kauanSR-DEv/telemetria-esp32/docs/relatorio/README.md

# Relatório

[Abrir o relatório em PDF](<Relatorio_Telemetria_ESP32 OFICIAL.pdf>) · [Abrir em Word](<Relatorio_Telemetria_ESP32 OFICIAL.docx>).

O documento reúne a especificação, a montagem, os resultados das sete condições, as medidas de desempenho e o caso real de erro não detectado. Os [registros integrais](../../resultados/coletas/README.md) e as [tabelas](../../resultados/tabelas/README.md) permitem conferir os resultados.
