kauanSR-DEv/telemetria-esp32/resultados/README.md

# Resultados experimentais

As sete condições foram coletadas em 19/10/2026, com N = 1000 e semente 1. SUM cobre os modos 0 a 3; CRC-8 cobre os modos 1 a 3.

- [Tabelas consolidadas](tabelas/README.md): contagens, taxa e links para as rodadas.
- [Coletas completas](coletas/README.md): registros originais, CSVs e metadados.
- [Erro não detectado real](../docs/erro-nao-detectado.md): bytes e cálculo de SUM.

CRC-8 modo 1 é apresentado com ressalva de integridade documental, descrita no resumo da rodada. As demais seis condições passaram pela validação estrita. Os registros originais foram mantidos sem alteração.
