kauanSR-DEv/telemetria-esp32/resultados/tabelas/README.md

# Resultados consolidados

Somente rodadas válidas com 1000 classificações do RX. As ressalvas de registro, quando aceitas pela auditoria cruzada, são indicadas nos links. Se houver repetição, usa-se a pasta datada mais recente.

Taxa = ND / (CORROMPIDO + ND) × 100. NA: denominador zero.

## SUM

| Modo | OK | CORROMPIDO | PERDIDO | Não detectado | Taxa (%) |
|---|---:|---:|---:|---:|---:|
| 0 | 1000 | 0 | 0 | 0 | NA |
| 1 | 616 | 368 | 16 | 0 | 0 |
| 2 | 384 | 576 | 38 | 2 | 0.346021 |
| 3 | 174 | 740 | 86 | 0 | 0 |

- Modo 0: [resumo e logs](../coletas/20261019_174927_927081_SUM_M0_seed1/resumo.md) · semente 1
- Modo 1: [resumo e logs](../coletas/20261019_175048_578874_SUM_M1_seed1/resumo.md) · semente 1
- Modo 2: [resumo e logs](../coletas/20261019_175257_105181_SUM_M2_seed1/resumo.md) · semente 1
- Modo 3: [resumo e logs](../coletas/20261019_175441_404069_SUM_M3_seed1/resumo.md) · semente 1

## CRC8

| Modo | OK | CORROMPIDO | PERDIDO | Não detectado | Taxa (%) |
|---|---:|---:|---:|---:|---:|
| 1 | 621 | 363 | 16 | 0 | 0 |
| 2 | 399 | 563 | 38 | 0 | 0 |
| 3 | 167 | 747 | 86 | 0 | 0 |

- Modo 1: [resumo e logs](../coletas/20261019_180738_095814_CRC8_M1_seed1/resumo.md) · semente 1 · **com ressalvas de registro**
- Modo 2: [resumo e logs](../coletas/20261019_181355_979307_CRC8_M2_seed1/resumo.md) · semente 1
- Modo 3: [resumo e logs](../coletas/20261019_181546_219907_CRC8_M3_seed1/resumo.md) · semente 1
