kauanSR-DEv/telemetria-esp32/resultados/coletas/20261019_174927_927081_SUM_M0_seed1/resumo.md

# SUM · modo 0

Coleta: **VÁLIDA** · N = 1000 · semente = 1

| Modo | OK | CORROMPIDO | PERDIDO | Não detectado | Taxa (%) |
|---|---:|---:|---:|---:|---:|
| 0 | 1000 | 0 | 0 | 0 | NA |

A tabela descreve as decisões realmente registradas pelo RX. Apenas coletas válidas, inclusive com ressalvas explícitas, e com 1000 classificações entram nas tabelas finais.

| Medida | Média | Mínimo | Máximo | Amostras |
|---|---:|---:|---:|---:|
| calculo_tx_us | 1.001 | 1 | 2 | 1000 |
| verificacao_rx_us | 3.492 | 3 | 4 | 1000 |
| intervalo_tx_us | 50999.998999 | 50999 | 51000 | 999 |
| intervalo_rx_us | 51001.011011 | 50996 | 51957 | 999 |
| recuperacao_rx_ms | NA | NA | NA | 0 |

Overhead: 6 bytes por quadro, excluindo referência e bits de início/parada.
NA indica ausência de amostra ou denominador zero; não significa zero medido.

## Evidências

[TXT original do TX](tx.txt) · [TXT original do RX](rx.txt) · [TXT original do NOISE](noise.txt)

[Erros não detectados desta coleta](evidencias_nd.csv)
