kauanSR-DEv/telemetria-esp32/resultados/tabelas/CRC8.csv

Modo | OK | CORROMPIDO | PERDIDO | Não detectado | Taxa de não detecção (%)
1 | 621 | 363 | 16 | 0 | 0
2 | 399 | 563 | 38 | 0 | 0
3 | 167 | 747 | 86 | 0 | 0
