kauanSR-DEv/telemetria-esp32/resultados/coletas/20261019_174927_927081_SUM_M0_seed1/comandos.csv

horario_computador | placa | comando
2026-10-19T17:49:31.029342-04:00 | TX | STATUS
2026-10-19T17:49:31.029722-04:00 | TX | HELP
2026-10-19T17:49:31.080947-04:00 | RX | STATUS
2026-10-19T17:49:31.081238-04:00 | RX | HELP
2026-10-19T17:49:31.132462-04:00 | NOISE | STATUS
2026-10-19T17:49:31.132758-04:00 | NOISE | HELP
2026-10-19T17:49:31.163753-04:00 | TX | SUM
2026-10-19T17:49:31.194179-04:00 | RX | SUM
2026-10-19T17:49:31.224697-04:00 | NOISE | MODE 0
2026-10-19T17:49:31.255328-04:00 | NOISE | SEED 1
2026-10-19T17:49:31.286337-04:00 | RX | START 1000
2026-10-19T17:49:31.337244-04:00 | NOISE | START 1000
2026-10-19T17:49:31.398397-04:00 | TX | START 1000
2026-10-19T17:50:22.467437-04:00 | RX | END
2026-10-19T17:50:22.467819-04:00 | NOISE | END
