kauanSR-DEv/telemetria-esp32/resultados/coletas/20261019_174927_927081_SUM_M0_seed1/noise.csv

tipo | sessao | modo | indice | seq_original | t_sof_us | posicoes_byte_bit | alvos_hex | original_hex | receptor_hex | alvos_n | mudancas_n | xor_hex | eventos_planejados_ticks | atraso_max_ticks | eventos_aplicados_ticks | debug_original_hex | debug_receptor_hex | falhas_mask | qualidade
QUADRO | 3 | 0 | 0 | 0 | 3157584260 | NA | 0000000000000000 | A55A0200005E2977 | A55A0200005E2977 | 0 | 0 | 0000000000000000 | NA | 0 | NA | D3910000025E29 | D3910000025E29 | 0 | VALIDO
QUADRO | 3 | 0 | 1 | 1 | 3157635259 | NA | 0000000000000000 | A55A0200010DB937 | A55A0200010DB937 | 0 | 0 | 0000000000000000 | NA | 0 | NA | D3910001020DB9 | D3910001020DB9 | 0 | VALIDO
QUADRO | 3 | 0 | 2 | 2 | 3157686259 | NA | 0000000000000000 | A55A020002F55BAC | A55A020002F55BAC | 0 | 0 | 0000000000000000 | NA | 0 | NA | D391000202F55B | D391000202F55B | 0 | VALIDO
QUADRO | 3 | 0 | 3 | 3 | 3157737259 | NA | 0000000000000000 | A55A020003968FD6 | A55A020003968FD6 | 0 | 0 | 0000000000000000 | NA | 0 | NA | D391000302968F | D391000302968F | 0 | VALIDO
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
