kauanSR-DEv/telemetria-esp32/resultados/coletas/20261019_174927_927081_SUM_M0_seed1/rx.csv

sessao | tecnica | seq_original | seq_recebida | id_rx | t_sof_us | intervalo_us | residuo | decisao | payload_recebido | payload_referencia | payload_confere | verificacao_us | recuperacao_ms | classe | motivo | evento_seq
3 | SUM | 0 | 0 | 1 | 3015958233 | NA | 00 | ACEITO | 5E29 | 5E29 | SIM | 4 | NA | OK | NENHUM | ORDEM
3 | SUM | 1 | 1 | 2 | 3016009242 | 51009 | 00 | ACEITO | 0DB9 | 0DB9 | SIM | 4 | NA | OK | NENHUM | ORDEM
3 | SUM | 2 | 2 | 3 | 3016060241 | 50999 | 00 | ACEITO | F55B | F55B | SIM | 4 | NA | OK | NENHUM | ORDEM
3 | SUM | 3 | 3 | 4 | 3016111242 | 51001 | 00 | ACEITO | 968F | 968F | SIM | 4 | NA | OK | NENHUM | ORDEM
3 | SUM | 4 | 4 | 5 | 3016162241 | 50999 | 00 | ACEITO | A5F3 | A5F3 | SIM | 4 | NA | OK | NENHUM | ORDEM
3 | SUM | 5 | 5 | 6 | 3016213243 | 51002 | 00 | ACEITO | 1EAC | 1EAC | SIM | 4 | NA | OK | NENHUM | ORDEM
3 | SUM | 6 | 6 | 7 | 3016264242 | 50999 | 00 | ACEITO | 41AA | 41AA | SIM | 4 | NA | OK | NENHUM | ORDEM
3 | SUM | 7 | 7 | 8 | 3016315243 | 51001 | 00 | ACEITO | 59E0 | 59E0 | SIM | 4 | NA | OK | NENHUM | ORDEM
3 | SUM | 8 | 8 | 9 | 3016366242 | 50999 | 00 | ACEITO | E071 | E071 | SIM | 4 | NA | OK | NENHUM | ORDEM
3 | SUM | 9 | 9 | 10 | 3016417243 | 51001 | 00 | ACEITO | D691 | D691 | SIM | 4 | NA | OK | NENHUM | ORDEM
3 | SUM | 10 | 10 | 11 | 3016468242 | 50999 | 00 | ACEITO | 0154 | 0154 | SIM | 4 | NA | OK | NENHUM | ORDEM
3 | SUM | 11 | 11 | 12 | 3016519243 | 51001 | 00 | ACEITO | 05DA | 05DA | SIM | 4 | NA | OK | NENHUM | ORDEM
3 | SUM | 12 | 12 | 13 | 3016570242 | 50999 | 00 | ACEITO | 49A3 | 49A3 | SIM | 4 | NA | OK | NENHUM | ORDEM
3 | SUM | 13 | 13 | 14 | 3016621243 | 51001 | 00 | ACEITO | AEA4 | AEA4 | SIM | 4 | NA | OK | NENHUM | ORDEM
3 | SUM | 14 | 14 | 15 | 3016672242 | 50999 | 00 | ACEITO | B36F | B36F | SIM | 4 | NA | OK | NENHUM | ORDEM
3 | SUM | 15 | 15 | 16 | 3016723243 | 51001 | 00 | ACEITO | 53DB | 53DB | SIM | 4 | NA | OK | NENHUM | ORDEM
3 | SUM | 16 | 16 | 17 | 3016774242 | 50999 | 00 | ACEITO | E1AF | E1AF | SIM | 4 | NA | OK | NENHUM | ORDEM
3 | SUM | 17 | 17 | 18 | 3016825243 | 51001 | 00 | ACEITO | 8E6F | 8E6F | SIM | 4 | NA | OK | NENHUM | ORDEM
3 | SUM | 18 | 18 | 19 | 3016876243 | 51000 | 00 | ACEITO | 67A5 | 67A5 | SIM | 4 | NA | OK | NENHUM | ORDEM
3 | SUM | 19 | 19 | 20 | 3016927244 | 51001 | 00 | ACEITO | 58C7 | 58C7 | SIM | 4 | NA | OK | NENHUM | ORDEM
3 | SUM | 20 | 20 | 21 | 3016978243 | 50999 | 00 | ACEITO | 27D3 | 27D3 | SIM | 4 | NA | OK | NENHUM | ORDEM
3 | SUM | 21 | 21 | 22 | 3017029244 | 51001 | 00 | ACEITO | 7564 | 7564 | SIM | 4 | NA | OK | NENHUM | ORDEM
3 | SUM | 22 | 22 | 23 | 3017080243 | 50999 | 00 | ACEITO | 6061 | 6061 | SIM | 4 | NA | OK | NENHUM | ORDEM
3 | SUM | 23 | 23 | 24 | 3017131244 | 51001 | 00 | ACEITO | 2A09 | 2A09 | SIM | 4 | NA | OK | NENHUM | ORDEM
3 | SUM | 24 | 24 | 25 | 3017182243 | 50999 | 00 | ACEITO | 4244 | 4244 | SIM | 4 | NA | OK | NENHUM | ORDEM
3 | SUM | 25 | 25 | 26 | 3017233244 | 51001 | 00 | ACEITO | 47DA | 47DA | SIM | 4 | NA | OK | NENHUM | ORDEM
3 | SUM | 26 | 26 | 27 | 3017284243 | 50999 | 00 | ACEITO | EFB5 | EFB5 | SIM | 4 | NA | OK | NENHUM | ORDEM
3 | SUM | 27 | 27 | 28 | 3017335244 | 51001 | 00 | ACEITO | 8D2C | 8D2C | SIM | 4 | NA | OK | NENHUM | ORDEM
3 | SUM | 28 | 28 | 29 | 3017386243 | 50999 | 00 | ACEITO | E92C | E92C | SIM | 4 | NA | OK | NENHUM | ORDEM
3 | SUM | 29 | 29 | 30 | 3017437244 | 51001 | 00 | ACEITO | 92AA | 92AA | SIM | 4 | NA | OK | NENHUM | ORDEM
3 | SUM | 30 | 30 | 31 | 3017488243 | 50999 | 00 | ACEITO | CD3E | CD3E | SIM | 4 | NA | OK | NENHUM | ORDEM
3 | SUM | 31 | 31 | 32 | 3017539245 | 51002 | 00 | ACEITO | 6066 | 6066 | SIM | 4 | NA | OK | NENHUM | ORDEM
3 | SUM | 32 | 32 | 33 | 3017590244 | 50999 | 00 | ACEITO | CA1C | CA1C | SIM | 4 | NA | OK | NENHUM | ORDEM
3 | SUM | 33 | 33 | 34 | 3017641245 | 51001 | 00 | ACEITO | EACD | EACD | SIM | 4 | NA | OK | NENHUM | ORDEM
3 | SUM | 34 | 34 | 35 | 3017692244 | 50999 | 00 | ACEITO | 3F28 | 3F28 | SIM | 4 | NA | OK | NENHUM | ORDEM
3 | SUM | 35 | 35 | 36 | 3017743245 | 51001 | 00 | ACEITO | BAEC | BAEC | SIM | 4 | NA | OK | NENHUM | ORDEM
3 | SUM | 36 | 36 | 37 | 3017794244 | 50999 | 00 | ACEITO | 0FF3 | 0FF3 | SIM | 4 | NA | OK | NENHUM | ORDEM
3 | SUM | 37 | 37 | 38 | 3017845245 | 51001 | 00 | ACEITO | 774E | 774E | SIM | 4 | NA | OK | NENHUM | ORDEM
3 | SUM | 38 | 38 | 39 | 3017896244 | 50999 | 00 | ACEITO | 446B | 446B | SIM | 4 | NA | OK | NENHUM | ORDEM
3 | SUM | 39 | 39 | 40 | 3017947245 | 51001 | 00 | ACEITO | 8DC5 | 8DC5 | SIM | 4 | NA | OK | NENHUM | ORDEM
3 | SUM | 40 | 40 | 41 | 3017998244 | 50999 | 00 | ACEITO | C9DC | C9DC | SIM | 4 | NA | OK | NENHUM | ORDEM
3 | SUM | 41 | 41 | 42 | 3018049245 | 51001 | 00 | ACEITO | 5E83 | 5E83 | SIM | 4 | NA | OK | NENHUM | ORDEM
3 | SUM | 42 | 42 | 43 | 3018100244 | 50999 | 00 | ACEITO | E650 | E650 | SIM | 4 | NA | OK | NENHUM | ORDEM
3 | SUM | 43 | 43 | 44 | 3018151245 | 51001 | 00 | ACEITO | 18CB | 18CB | SIM | 4 | NA | OK | NENHUM | ORDEM
3 | SUM | 44 | 44 | 45 | 3018202243 | 50998 | 00 | ACEITO | 26D8 | 26D8 | SIM | 3 | NA | OK | NENHUM | ORDEM
3 | SUM | 45 | 45 | 46 | 3018253244 | 51001 | 00 | ACEITO | 40A3 | 40A3 | SIM | 4 | NA | OK | NENHUM | ORDEM
3 | SUM | 46 | 46 | 47 | 3018304243 | 50999 | 00 | ACEITO | 0040 | 0040 | SIM | 3 | NA | OK | NENHUM | ORDEM
3 | SUM | 47 | 47 | 48 | 3018355244 | 51001 | 00 | ACEITO | 9189 | 9189 | SIM | 4 | NA | OK | NENHUM | ORDEM
3 | SUM | 48 | 48 | 49 | 3018406243 | 50999 | 00 | ACEITO | 7CF8 | 7CF8 | SIM | 3 | NA | OK | NENHUM | ORDEM
3 | SUM | 49 | 49 | 50 | 3018457244 | 51001 | 00 | ACEITO | 58BB | 58BB | SIM | 4 | NA | OK | NENHUM | ORDEM
3 | SUM | 50 | 50 | 51 | 3018508243 | 50999 | 00 | ACEITO | 83E3 | 83E3 | SIM | 3 | NA | OK | NENHUM | ORDEM
3 | SUM | 51 | 51 | 52 | 3018559244 | 51001 | 00 | ACEITO | 5B1B | 5B1B | SIM | 4 | NA | OK | NENHUM | ORDEM
3 | SUM | 52 | 52 | 53 | 3018610243 | 50999 | 00 | ACEITO | F6B7 | F6B7 | SIM | 3 | NA | OK | NENHUM | ORDEM
3 | SUM | 53 | 53 | 54 | 3018661244 | 51001 | 00 | ACEITO | 38C8 | 38C8 | SIM | 4 | NA | OK | NENHUM | ORDEM
3 | SUM | 54 | 54 | 55 | 3018712243 | 50999 | 00 | ACEITO | 7597 | 7597 | SIM | 3 | NA | OK | NENHUM | ORDEM
3 | SUM | 55 | 55 | 56 | 3018763244 | 51001 | 00 | ACEITO | 0E86 | 0E86 | SIM | 4 | NA | OK | NENHUM | ORDEM
3 | SUM | 56 | 56 | 57 | 3018814243 | 50999 | 00 | ACEITO | 6A7A | 6A7A | SIM | 3 | NA | OK | NENHUM | ORDEM
3 | SUM | 57 | 57 | 58 | 3018865245 | 51002 | 00 | ACEITO | C42D | C42D | SIM | 4 | NA | OK | NENHUM | ORDEM
3 | SUM | 58 | 58 | 59 | 3018916244 | 50999 | 00 | ACEITO | E763 | E763 | SIM | 3 | NA | OK | NENHUM | ORDEM
3 | SUM | 59 | 59 | 60 | 3018967245 | 51001 | 00 | ACEITO | 5B8B | 5B8B | SIM | 4 | NA | OK | NENHUM | ORDEM
3 | SUM | 60 | 60 | 61 | 3019018244 | 50999 | 00 | ACEITO | AAF8 | AAF8 | SIM | 3 | NA | OK | NENHUM | ORDEM
3 | SUM | 61 | 61 | 62 | 3019069245 | 51001 | 00 | ACEITO | 6457 | 6457 | SIM | 4 | NA | OK | NENHUM | ORDEM
3 | SUM | 62 | 62 | 63 | 3019120244 | 50999 | 00 | ACEITO | 4441 | 4441 | SIM | 3 | NA | OK | NENHUM | ORDEM
3 | SUM | 63 | 63 | 64 | 3019171245 | 51001 | 00 | ACEITO | 941B | 941B | SIM | 4 | NA | OK | NENHUM | ORDEM
3 | SUM | 64 | 64 | 65 | 3019222244 | 50999 | 00 | ACEITO | 0F01 | 0F01 | SIM | 3 | NA | OK | NENHUM | ORDEM
3 | SUM | 65 | 65 | 66 | 3019273245 | 51001 | 00 | ACEITO | 0F39 | 0F39 | SIM | 4 | NA | OK | NENHUM | ORDEM
3 | SUM | 66 | 66 | 67 | 3019324244 | 50999 | 00 | ACEITO | 2409 | 2409 | SIM | 3 | NA | OK | NENHUM | ORDEM
3 | SUM | 67 | 67 | 68 | 3019375245 | 51001 | 00 | ACEITO | C6FB | C6FB | SIM | 4 | NA | OK | NENHUM | ORDEM
3 | SUM | 68 | 68 | 69 | 3019426244 | 50999 | 00 | ACEITO | 9C76 | 9C76 | SIM | 3 | NA | OK | NENHUM | ORDEM
3 | SUM | 69 | 69 | 70 | 3019477245 | 51001 | 00 | ACEITO | F04C | F04C | SIM | 4 | NA | OK | NENHUM | ORDEM
3 | SUM | 70 | 70 | 71 | 3019528245 | 51000 | 00 | ACEITO | 217C | 217C | SIM | 3 | NA | OK | NENHUM | ORDEM
3 | SUM | 71 | 71 | 72 | 3019579246 | 51001 | 00 | ACEITO | 4486 | 4486 | SIM | 4 | NA | OK | NENHUM | ORDEM
3 | SUM | 72 | 72 | 73 | 3019630245 | 50999 | 00 | ACEITO | 5C5C | 5C5C | SIM | 3 | NA | OK | NENHUM | ORDEM
3 | SUM | 73 | 73 | 74 | 3019681246 | 51001 | 00 | ACEITO | 1E13 | 1E13 | SIM | 4 | NA | OK | NENHUM | ORDEM
3 | SUM | 74 | 74 | 75 | 3019732245 | 50999 | 00 | ACEITO | 2A9A | 2A9A | SIM | 3 | NA | OK | NENHUM | ORDEM
3 | SUM | 75 | 75 | 76 | 3019783246 | 51001 | 00 | ACEITO | 847D | 847D | SIM | 4 | NA | OK | NENHUM | ORDEM
3 | SUM | 76 | 76 | 77 | 3019834245 | 50999 | 00 | ACEITO | 952E | 952E | SIM | 3 | NA | OK | NENHUM | ORDEM
3 | SUM | 77 | 77 | 78 | 3019885246 | 51001 | 00 | ACEITO | 6B37 | 6B37 | SIM | 4 | NA | OK | NENHUM | ORDEM
3 | SUM | 78 | 78 | 79 | 3019936245 | 50999 | 00 | ACEITO | 400F | 400F | SIM | 3 | NA | OK | NENHUM | ORDEM
3 | SUM | 79 | 79 | 80 | 3019987246 | 51001 | 00 | ACEITO | 9D91 | 9D91 | SIM | 4 | NA | OK | NENHUM | ORDEM
3 | SUM | 80 | 80 | 81 | 3020038245 | 50999 | 00 | ACEITO | 9CE9 | 9CE9 | SIM | 3 | NA | OK | NENHUM | ORDEM
3 | SUM | 81 | 81 | 82 | 3020089246 | 51001 | 00 | ACEITO | 85F0 | 85F0 | SIM | 4 | NA | OK | NENHUM | ORDEM
3 | SUM | 82 | 82 | 83 | 3020140245 | 50999 | 00 | ACEITO | 7D11 | 7D11 | SIM | 4 | NA | OK | NENHUM | ORDEM
3 | SUM | 83 | 83 | 84 | 3020191247 | 51002 | 00 | ACEITO | 4B62 | 4B62 | SIM | 4 | NA | OK | NENHUM | ORDEM
3 | SUM | 84 | 84 | 85 | 3020242246 | 50999 | 00 | ACEITO | 4088 | 4088 | SIM | 3 | NA | OK | NENHUM | ORDEM
3 | SUM | 85 | 85 | 86 | 3020293247 | 51001 | 00 | ACEITO | 70A0 | 70A0 | SIM | 4 | NA | OK | NENHUM | ORDEM
3 | SUM | 86 | 86 | 87 | 3020344246 | 50999 | 00 | ACEITO | 8F60 | 8F60 | SIM | 3 | NA | OK | NENHUM | ORDEM
3 | SUM | 87 | 87 | 88 | 3020395247 | 51001 | 00 | ACEITO | CD66 | CD66 | SIM | 4 | NA | OK | NENHUM | ORDEM
3 | SUM | 88 | 88 | 89 | 3020446246 | 50999 | 00 | ACEITO | 0A15 | 0A15 | SIM | 3 | NA | OK | NENHUM | ORDEM
3 | SUM | 89 | 89 | 90 | 3020497247 | 51001 | 00 | ACEITO | 7C14 | 7C14 | SIM | 4 | NA | OK | NENHUM | ORDEM
3 | SUM | 90 | 90 | 91 | 3020548246 | 50999 | 00 | ACEITO | CB2C | CB2C | SIM | 3 | NA | OK | NENHUM | ORDEM
3 | SUM | 91 | 91 | 92 | 3020599247 | 51001 | 00 | ACEITO | 4323 | 4323 | SIM | 4 | NA | OK | NENHUM | ORDEM
3 | SUM | 92 | 92 | 93 | 3020650246 | 50999 | 00 | ACEITO | 7FEA | 7FEA | SIM | 3 | NA | OK | NENHUM | ORDEM
3 | SUM | 93 | 93 | 94 | 3020701247 | 51001 | 00 | ACEITO | 2B15 | 2B15 | SIM | 4 | NA | OK | NENHUM | ORDEM
3 | SUM | 94 | 94 | 95 | 3020752246 | 50999 | 00 | ACEITO | D053 | D053 | SIM | 3 | NA | OK | NENHUM | ORDEM
3 | SUM | 95 | 95 | 96 | 3020803247 | 51001 | 00 | ACEITO | 7CD1 | 7CD1 | SIM | 4 | NA | OK | NENHUM | ORDEM
3 | SUM | 96 | 96 | 97 | 3020854247 | 51000 | 00 | ACEITO | 6E5B | 6E5B | SIM | 3 | NA | OK | NENHUM | ORDEM
3 | SUM | 97 | 97 | 98 | 3020905248 | 51001 | 00 | ACEITO | E966 | E966 | SIM | 4 | NA | OK | NENHUM | ORDEM
3 | SUM | 98 | 98 | 99 | 3020956247 | 50999 | 00 | ACEITO | DC7D | DC7D | SIM | 3 | NA | OK | NENHUM | ORDEM
3 | SUM | 99 | 99 | 100 | 3021007248 | 51001 | 00 | ACEITO | CD1C | CD1C | SIM | 4 | NA | OK | NENHUM | ORDEM
3 | SUM | 100 | 100 | 101 | 3021058247 | 50999 | 00 | ACEITO | AF0F | AF0F | SIM | 3 | NA | OK | NENHUM | ORDEM
3 | SUM | 101 | 101 | 102 | 3021109248 | 51001 | 00 | ACEITO | C0FF | C0FF | SIM | 4 | NA | OK | NENHUM | ORDEM
3 | SUM | 102 | 102 | 103 | 3021160247 | 50999 | 00 | ACEITO | 2A83 | 2A83 | SIM | 3 | NA | OK | NENHUM | ORDEM
3 | SUM | 103 | 103 | 104 | 3021211248 | 51001 | 00 | ACEITO | CD7C | CD7C | SIM | 4 | NA | OK | NENHUM | ORDEM
3 | SUM | 104 | 104 | 105 | 3021262247 | 50999 | 00 | ACEITO | 7B41 | 7B41 | SIM | 3 | NA | OK | NENHUM | ORDEM
3 | SUM | 105 | 105 | 106 | 3021313248 | 51001 | 00 | ACEITO | 3543 | 3543 | SIM | 4 | NA | OK | NENHUM | ORDEM
3 | SUM | 106 | 106 | 107 | 3021364247 | 50999 | 00 | ACEITO | 304E | 304E | SIM | 3 | NA | OK | NENHUM | ORDEM
3 | SUM | 107 | 107 | 108 | 3021415248 | 51001 | 00 | ACEITO | 601B | 601B | SIM | 4 | NA | OK | NENHUM | ORDEM
3 | SUM | 108 | 108 | 109 | 3021466247 | 50999 | 00 | ACEITO | 103A | 103A | SIM | 3 | NA | OK | NENHUM | ORDEM
3 | SUM | 109 | 109 | 110 | 3021517249 | 51002 | 00 | ACEITO | 643E | 643E | SIM | 4 | NA | OK | NENHUM | ORDEM
3 | SUM | 110 | 110 | 111 | 3021568248 | 50999 | 00 | ACEITO | 7393 | 7393 | SIM | 3 | NA | OK | NENHUM | ORDEM
3 | SUM | 111 | 111 | 112 | 3021619249 | 51001 | 00 | ACEITO | 2531 | 2531 | SIM | 4 | NA | OK | NENHUM | ORDEM
3 | SUM | 112 | 112 | 113 | 3021670248 | 50999 | 00 | ACEITO | 54E8 | 54E8 | SIM | 3 | NA | OK | NENHUM | ORDEM
3 | SUM | 113 | 113 | 114 | 3021721249 | 51001 | 00 | ACEITO | C522 | C522 | SIM | 4 | NA | OK | NENHUM | ORDEM
3 | SUM | 114 | 114 | 115 | 3021772248 | 50999 | 00 | ACEITO | F609 | F609 | SIM | 3 | NA | OK | NENHUM | ORDEM
3 | SUM | 115 | 115 | 116 | 3021823249 | 51001 | 00 | ACEITO | 8EC9 | 8EC9 | SIM | 4 | NA | OK | NENHUM | ORDEM
3 | SUM | 116 | 116 | 117 | 3021874248 | 50999 | 00 | ACEITO | D8D2 | D8D2 | SIM | 3 | NA | OK | NENHUM | ORDEM
3 | SUM | 117 | 117 | 118 | 3021925249 | 51001 | 00 | ACEITO | 1870 | 1870 | SIM | 4 | NA | OK | NENHUM | ORDEM
3 | SUM | 118 | 118 | 119 | 3021976248 | 50999 | 00 | ACEITO | 3080 | 3080 | SIM | 3 | NA | OK | NENHUM | ORDEM
3 | SUM | 119 | 119 | 120 | 3022027249 | 51001 | 00 | ACEITO | 6C39 | 6C39 | SIM | 4 | NA | OK | NENHUM | ORDEM
3 | SUM | 120 | 120 | 121 | 3022078248 | 50999 | 00 | ACEITO | C5CD | C5CD | SIM | 3 | NA | OK | NENHUM | ORDEM
3 | SUM | 121 | 121 | 122 | 3022129249 | 51001 | 00 | ACEITO | 3D47 | 3D47 | SIM | 4 | NA | OK | NENHUM | ORDEM
3 | SUM | 122 | 122 | 123 | 3022180249 | 51000 | 00 | ACEITO | 64D4 | 64D4 | SIM | 3 | NA | OK | NENHUM | ORDEM
3 | SUM | 123 | 123 | 124 | 3022231250 | 51001 | 00 | ACEITO | 7609 | 7609 | SIM | 4 | NA | OK | NENHUM | ORDEM
3 | SUM | 124 | 124 | 125 | 3022282249 | 50999 | 00 | ACEITO | 906B | 906B | SIM | 3 | NA | OK | NENHUM | ORDEM
3 | SUM | 125 | 125 | 126 | 3022333250 | 51001 | 00 | ACEITO | 8DCA | 8DCA | SIM | 4 | NA | OK | NENHUM | ORDEM
3 | SUM | 126 | 126 | 127 | 3022384249 | 50999 | 00 | ACEITO | 0A1F | 0A1F | SIM | 3 | NA | OK | NENHUM | ORDEM
3 | SUM | 127 | 127 | 128 | 3022435250 | 51001 | 00 | ACEITO | E11A | E11A | SIM | 4 | NA | OK | NENHUM | ORDEM
3 | SUM | 128 | 128 | 129 | 3022486249 | 50999 | 00 | ACEITO | 5A79 | 5A79 | SIM | 3 | NA | OK | NENHUM | ORDEM
3 | SUM | 129 | 129 | 130 | 3022537250 | 51001 | 00 | ACEITO | ED6F | ED6F | SIM | 4 | NA | OK | NENHUM | ORDEM
3 | SUM | 130 | 130 | 131 | 3022588249 | 50999 | 00 | ACEITO | 443F | 443F | SIM | 3 | NA | OK | NENHUM | ORDEM
3 | SUM | 131 | 131 | 132 | 3022639250 | 51001 | 00 | ACEITO | 8298 | 8298 | SIM | 4 | NA | OK | NENHUM | ORDEM
3 | SUM | 132 | 132 | 133 | 3022690249 | 50999 | 00 | ACEITO | 3FFC | 3FFC | SIM | 3 | NA | OK | NENHUM | ORDEM
3 | SUM | 133 | 133 | 134 | 3022741250 | 51001 | 00 | ACEITO | 458B | 458B | SIM | 4 | NA | OK | NENHUM | ORDEM
3 | SUM | 134 | 134 | 135 | 3022792249 | 50999 | 00 | ACEITO | 5944 | 5944 | SIM | 3 | NA | OK | NENHUM | ORDEM
3 | SUM | 135 | 135 | 136 | 3022843251 | 51002 | 00 | ACEITO | AF66 | AF66 | SIM | 4 | NA | OK | NENHUM | ORDEM
3 | SUM | 136 | 136 | 137 | 3022894250 | 50999 | 00 | ACEITO | A372 | A372 | SIM | 3 | NA | OK | NENHUM | ORDEM
3 | SUM | 137 | 137 | 138 | 3022945251 | 51001 | 00 | ACEITO | 4AEC | 4AEC | SIM | 4 | NA | OK | NENHUM | ORDEM
3 | SUM | 138 | 138 | 139 | 3022996250 | 50999 | 00 | ACEITO | 9248 | 9248 | SIM | 3 | NA | OK | NENHUM | ORDEM
3 | SUM | 139 | 139 | 140 | 3023047251 | 51001 | 00 | ACEITO | 88A5 | 88A5 | SIM | 4 | NA | OK | NENHUM | ORDEM
3 | SUM | 140 | 140 | 141 | 3023098250 | 50999 | 00 | ACEITO | 3D47 | 3D47 | SIM | 3 | NA | OK | NENHUM | ORDEM
3 | SUM | 141 | 141 | 142 | 3023149251 | 51001 | 00 | ACEITO | 2439 | 2439 | SIM | 4 | NA | OK | NENHUM | ORDEM
3 | SUM | 142 | 142 | 143 | 3023200250 | 50999 | 00 | ACEITO | 4A72 | 4A72 | SIM | 3 | NA | OK | NENHUM | ORDEM
3 | SUM | 143 | 143 | 144 | 3023251251 | 51001 | 00 | ACEITO | 3114 | 3114 | SIM | 4 | NA | OK | NENHUM | ORDEM
3 | SUM | 144 | 144 | 145 | 3023302250 | 50999 | 00 | ACEITO | E395 | E395 | SIM | 3 | NA | OK | NENHUM | ORDEM
3 | SUM | 145 | 145 | 146 | 3023353251 | 51001 | 00 | ACEITO | 9338 | 9338 | SIM | 4 | NA | OK | NENHUM | ORDEM
3 | SUM | 146 | 146 | 147 | 3023404250 | 50999 | 00 | ACEITO | FC16 | FC16 | SIM | 3 | NA | OK | NENHUM | ORDEM
3 | SUM | 147 | 147 | 148 | 3023455251 | 51001 | 00 | ACEITO | A592 | A592 | SIM | 4 | NA | OK | NENHUM | ORDEM
3 | SUM | 148 | 148 | 149 | 3023506253 | 51002 | 00 | ACEITO | AD5C | AD5C | SIM | 4 | NA | OK | NENHUM | ORDEM
3 | SUM | 149 | 149 | 150 | 3023557254 | 51001 | 00 | ACEITO | 54F6 | 54F6 | SIM | 4 | NA | OK | NENHUM | ORDEM
3 | SUM | 150 | 150 | 151 | 3023608253 | 50999 | 00 | ACEITO | 6793 | 6793 | SIM | 4 | NA | OK | NENHUM | ORDEM
3 | SUM | 151 | 151 | 152 | 3023659254 | 51001 | 00 | ACEITO | 6971 | 6971 | SIM | 4 | NA | OK | NENHUM | ORDEM
3 | SUM | 152 | 152 | 153 | 3023710253 | 50999 | 00 | ACEITO | 9DE0 | 9DE0 | SIM | 4 | NA | OK | NENHUM | ORDEM
3 | SUM | 153 | 153 | 154 | 3023761254 | 51001 | 00 | ACEITO | DD97 | DD97 | SIM | 4 | NA | OK | NENHUM | ORDEM
3 | SUM | 154 | 154 | 155 | 3023812253 | 50999 | 00 | ACEITO | BF16 | BF16 | SIM | 4 | NA | OK | NENHUM | ORDEM
3 | SUM | 155 | 155 | 156 | 3023863254 | 51001 | 00 | ACEITO | FDB3 | FDB3 | SIM | 4 | NA | OK | NENHUM | ORDEM
3 | SUM | 156 | 156 | 157 | 3023914253 | 50999 | 00 | ACEITO | A4C0 | A4C0 | SIM | 4 | NA | OK | NENHUM | ORDEM
3 | SUM | 157 | 157 | 158 | 3023965254 | 51001 | 00 | ACEITO | 1429 | 1429 | SIM | 4 | NA | OK | NENHUM | ORDEM
3 | SUM | 158 | 158 | 159 | 3024016253 | 50999 | 00 | ACEITO | 9BC6 | 9BC6 | SIM | 4 | NA | OK | NENHUM | ORDEM
3 | SUM | 159 | 159 | 160 | 3024067254 | 51001 | 00 | ACEITO | EDDD | EDDD | SIM | 4 | NA | OK | NENHUM | ORDEM
3 | SUM | 160 | 160 | 161 | 3024118253 | 50999 | 00 | ACEITO | 01A1 | 01A1 | SIM | 4 | NA | OK | NENHUM | ORDEM
3 | SUM | 161 | 161 | 162 | 3024169255 | 51002 | 00 | ACEITO | C57D | C57D | SIM | 4 | NA | OK | NENHUM | ORDEM
3 | SUM | 162 | 162 | 163 | 3024220254 | 50999 | 00 | ACEITO | 4D9F | 4D9F | SIM | 4 | NA | OK | NENHUM | ORDEM
3 | SUM | 163 | 163 | 164 | 3024271255 | 51001 | 00 | ACEITO | F0B5 | F0B5 | SIM | 4 | NA | OK | NENHUM | ORDEM
3 | SUM | 164 | 164 | 165 | 3024322254 | 50999 | 00 | ACEITO | CA6A | CA6A | SIM | 4 | NA | OK | NENHUM | ORDEM
3 | SUM | 165 | 165 | 166 | 3024373255 | 51001 | 00 | ACEITO | 7E11 | 7E11 | SIM | 4 | NA | OK | NENHUM | ORDEM
3 | SUM | 166 | 166 | 167 | 3024424254 | 50999 | 00 | ACEITO | C71E | C71E | SIM | 4 | NA | OK | NENHUM | ORDEM
3 | SUM | 167 | 167 | 168 | 3024475255 | 51001 | 00 | ACEITO | FDBD | FDBD | SIM | 4 | NA | OK | NENHUM | ORDEM
3 | SUM | 168 | 168 | 169 | 3024526254 | 50999 | 00 | ACEITO | 5B01 | 5B01 | SIM | 4 | NA | OK | NENHUM | ORDEM
3 | SUM | 169 | 169 | 170 | 3024577255 | 51001 | 00 | ACEITO | 1AF5 | 1AF5 | SIM | 4 | NA | OK | NENHUM | ORDEM
3 | SUM | 170 | 170 | 171 | 3024628254 | 50999 | 00 | ACEITO | AF79 | AF79 | SIM | 4 | NA | OK | NENHUM | ORDEM
3 | SUM | 171 | 171 | 172 | 3024679255 | 51001 | 00 | ACEITO | 1313 | 1313 | SIM | 4 | NA | OK | NENHUM | ORDEM
3 | SUM | 172 | 172 | 173 | 3024730254 | 50999 | 00 | ACEITO | 71EC | 71EC | SIM | 4 | NA | OK | NENHUM | ORDEM
3 | SUM | 173 | 173 | 174 | 3024781255 | 51001 | 00 | ACEITO | 4013 | 4013 | SIM | 4 | NA | OK | NENHUM | ORDEM
3 | SUM | 174 | 174 | 175 | 3024832255 | 51000 | 00 | ACEITO | AA9D | AA9D | SIM | 4 | NA | OK | NENHUM | ORDEM
3 | SUM | 175 | 175 | 176 | 3024883256 | 51001 | 00 | ACEITO | C471 | C471 | SIM | 4 | NA | OK | NENHUM | ORDEM
3 | SUM | 176 | 176 | 177 | 3024934255 | 50999 | 00 | ACEITO | E3A6 | E3A6 | SIM | 4 | NA | OK | NENHUM | ORDEM
3 | SUM | 177 | 177 | 178 | 3024985256 | 51001 | 00 | ACEITO | 676C | 676C | SIM | 4 | NA | OK | NENHUM | ORDEM
3 | SUM | 178 | 178 | 179 | 3025036255 | 50999 | 00 | ACEITO | 26F4 | 26F4 | SIM | 4 | NA | OK | NENHUM | ORDEM
3 | SUM | 179 | 179 | 180 | 3025087256 | 51001 | 00 | ACEITO | 81FE | 81FE | SIM | 4 | NA | OK | NENHUM | ORDEM
3 | SUM | 180 | 180 | 181 | 3025138255 | 50999 | 00 | ACEITO | BE0F | BE0F | SIM | 4 | NA | OK | NENHUM | ORDEM
3 | SUM | 181 | 181 | 182 | 3025189256 | 51001 | 00 | ACEITO | DC72 | DC72 | SIM | 4 | NA | OK | NENHUM | ORDEM
3 | SUM | 182 | 182 | 183 | 3025240255 | 50999 | 00 | ACEITO | 9AD6 | 9AD6 | SIM | 4 | NA | OK | NENHUM | ORDEM
3 | SUM | 183 | 183 | 184 | 3025291256 | 51001 | 00 | ACEITO | 4984 | 4984 | SIM | 4 | NA | OK | NENHUM | ORDEM
3 | SUM | 184 | 184 | 185 | 3025342255 | 50999 | 00 | ACEITO | 6E98 | 6E98 | SIM | 4 | NA | OK | NENHUM | ORDEM
3 | SUM | 185 | 185 | 186 | 3025393256 | 51001 | 00 | ACEITO | FC61 | FC61 | SIM | 4 | NA | OK | NENHUM | ORDEM
3 | SUM | 186 | 186 | 187 | 3025444255 | 50999 | 00 | ACEITO | 43F6 | 43F6 | SIM | 4 | NA | OK | NENHUM | ORDEM
3 | SUM | 187 | 187 | 188 | 3025495257 | 51002 | 00 | ACEITO | FB9D | FB9D | SIM | 4 | NA | OK | NENHUM | ORDEM
3 | SUM | 188 | 188 | 189 | 3025546256 | 50999 | 00 | ACEITO | 8111 | 8111 | SIM | 4 | NA | OK | NENHUM | ORDEM
3 | SUM | 189 | 189 | 190 | 3025597257 | 51001 | 00 | ACEITO | 8DAF | 8DAF | SIM | 4 | NA | OK | NENHUM | ORDEM
3 | SUM | 190 | 190 | 191 | 3025648256 | 50999 | 00 | ACEITO | 7A5F | 7A5F | SIM | 4 | NA | OK | NENHUM | ORDEM
3 | SUM | 191 | 191 | 192 | 3025699257 | 51001 | 00 | ACEITO | BF8C | BF8C | SIM | 4 | NA | OK | NENHUM | ORDEM
3 | SUM | 192 | 192 | 193 | 3025750256 | 50999 | 00 | ACEITO | 10BD | 10BD | SIM | 4 | NA | OK | NENHUM | ORDEM
3 | SUM | 193 | 193 | 194 | 3025801257 | 51001 | 00 | ACEITO | EFCF | EFCF | SIM | 4 | NA | OK | NENHUM | ORDEM
3 | SUM | 194 | 194 | 195 | 3025852256 | 50999 | 00 | ACEITO | B196 | B196 | SIM | 4 | NA | OK | NENHUM | ORDEM
3 | SUM | 195 | 195 | 196 | 3025903257 | 51001 | 00 | ACEITO | 0583 | 0583 | SIM | 4 | NA | OK | NENHUM | ORDEM
3 | SUM | 196 | 196 | 197 | 3025954256 | 50999 | 00 | ACEITO | 1FD3 | 1FD3 | SIM | 4 | NA | OK | NENHUM | ORDEM
3 | SUM | 197 | 197 | 198 | 3026005257 | 51001 | 00 | ACEITO | FA33 | FA33 | SIM | 4 | NA | OK | NENHUM | ORDEM
3 | SUM | 198 | 198 | 199 | 3026056256 | 50999 | 00 | ACEITO | 73E8 | 73E8 | SIM | 4 | NA | OK | NENHUM | ORDEM
3 | SUM | 199 | 199 | 200 | 3026107257 | 51001 | 00 | ACEITO | B32F | B32F | SIM | 4 | NA | OK | NENHUM | ORDEM
3 | SUM | 200 | 200 | 201 | 3026158257 | 51000 | 00 | ACEITO | 0D16 | 0D16 | SIM | 4 | NA | OK | NENHUM | ORDEM
3 | SUM | 201 | 201 | 202 | 3026209258 | 51001 | 00 | ACEITO | 11E6 | 11E6 | SIM | 4 | NA | OK | NENHUM | ORDEM
3 | SUM | 202 | 202 | 203 | 3026260257 | 50999 | 00 | ACEITO | 6D28 | 6D28 | SIM | 4 | NA | OK | NENHUM | ORDEM
3 | SUM | 203 | 203 | 204 | 3026311258 | 51001 | 00 | ACEITO | AC37 | AC37 | SIM | 4 | NA | OK | NENHUM | ORDEM
3 | SUM | 204 | 204 | 205 | 3026362257 | 50999 | 00 | ACEITO | 840F | 840F | SIM | 4 | NA | OK | NENHUM | ORDEM
3 | SUM | 205 | 205 | 206 | 3026413258 | 51001 | 00 | ACEITO | AA80 | AA80 | SIM | 4 | NA | OK | NENHUM | ORDEM
3 | SUM | 206 | 206 | 207 | 3026464257 | 50999 | 00 | ACEITO | A543 | A543 | SIM | 4 | NA | OK | NENHUM | ORDEM
3 | SUM | 207 | 207 | 208 | 3026515258 | 51001 | 00 | ACEITO | D5DF | D5DF | SIM | 4 | NA | OK | NENHUM | ORDEM
3 | SUM | 208 | 208 | 209 | 3026566257 | 50999 | 00 | ACEITO | FEF8 | FEF8 | SIM | 4 | NA | OK | NENHUM | ORDEM
3 | SUM | 209 | 209 | 210 | 3026617258 | 51001 | 00 | ACEITO | E032 | E032 | SIM | 4 | NA | OK | NENHUM | ORDEM
3 | SUM | 210 | 210 | 211 | 3026668257 | 50999 | 00 | ACEITO | 6C27 | 6C27 | SIM | 4 | NA | OK | NENHUM | ORDEM
3 | SUM | 211 | 211 | 212 | 3026719258 | 51001 | 00 | ACEITO | 8AE6 | 8AE6 | SIM | 4 | NA | OK | NENHUM | ORDEM
3 | SUM | 212 | 212 | 213 | 3026770257 | 50999 | 00 | ACEITO | E247 | E247 | SIM | 4 | NA | OK | NENHUM | ORDEM
3 | SUM | 213 | 213 | 214 | 3026821259 | 51002 | 00 | ACEITO | F6FF | F6FF | SIM | 4 | NA | OK | NENHUM | ORDEM
3 | SUM | 214 | 214 | 215 | 3026872258 | 50999 | 00 | ACEITO | 2F6B | 2F6B | SIM | 4 | NA | OK | NENHUM | ORDEM
3 | SUM | 215 | 215 | 216 | 3026923259 | 51001 | 00 | ACEITO | 04AD | 04AD | SIM | 4 | NA | OK | NENHUM | ORDEM
3 | SUM | 216 | 216 | 217 | 3026974258 | 50999 | 00 | ACEITO | C5B9 | C5B9 | SIM | 4 | NA | OK | NENHUM | ORDEM
3 | SUM | 217 | 217 | 218 | 3027025259 | 51001 | 00 | ACEITO | 0691 | 0691 | SIM | 4 | NA | OK | NENHUM | ORDEM
3 | SUM | 218 | 218 | 219 | 3027076258 | 50999 | 00 | ACEITO | B81C | B81C | SIM | 4 | NA | OK | NENHUM | ORDEM
3 | SUM | 219 | 219 | 220 | 3027127259 | 51001 | 00 | ACEITO | D7A4 | D7A4 | SIM | 4 | NA | OK | NENHUM | ORDEM
3 | SUM | 220 | 220 | 221 | 3027178258 | 50999 | 00 | ACEITO | CF7D | CF7D | SIM | 4 | NA | OK | NENHUM | ORDEM
3 | SUM | 221 | 221 | 222 | 3027229259 | 51001 | 00 | ACEITO | D18D | D18D | SIM | 4 | NA | OK | NENHUM | ORDEM
3 | SUM | 222 | 222 | 223 | 3027280258 | 50999 | 00 | ACEITO | D5F8 | D5F8 | SIM | 4 | NA | OK | NENHUM | ORDEM
3 | SUM | 223 | 223 | 224 | 3027331259 | 51001 | 00 | ACEITO | 5D26 | 5D26 | SIM | 4 | NA | OK | NENHUM | ORDEM
3 | SUM | 224 | 224 | 225 | 3027382258 | 50999 | 00 | ACEITO | 1064 | 1064 | SIM | 4 | NA | OK | NENHUM | ORDEM
3 | SUM | 225 | 225 | 226 | 3027433259 | 51001 | 00 | ACEITO | C7FD | C7FD | SIM | 4 | NA | OK | NENHUM | ORDEM
3 | SUM | 226 | 226 | 227 | 3027484257 | 50998 | 00 | ACEITO | BBE5 | BBE5 | SIM | 3 | NA | OK | NENHUM | ORDEM
3 | SUM | 227 | 227 | 228 | 3027535258 | 51001 | 00 | ACEITO | E6B8 | E6B8 | SIM | 4 | NA | OK | NENHUM | ORDEM
3 | SUM | 228 | 228 | 229 | 3027586257 | 50999 | 00 | ACEITO | 20AB | 20AB | SIM | 3 | NA | OK | NENHUM | ORDEM
3 | SUM | 229 | 229 | 230 | 3027637258 | 51001 | 00 | ACEITO | CB14 | CB14 | SIM | 4 | NA | OK | NENHUM | ORDEM
3 | SUM | 230 | 230 | 231 | 3027688257 | 50999 | 00 | ACEITO | 9EBD | 9EBD | SIM | 3 | NA | OK | NENHUM | ORDEM
3 | SUM | 231 | 231 | 232 | 3027739258 | 51001 | 00 | ACEITO | 5D2E | 5D2E | SIM | 4 | NA | OK | NENHUM | ORDEM
3 | SUM | 232 | 232 | 233 | 3027790257 | 50999 | 00 | ACEITO | 1478 | 1478 | SIM | 3 | NA | OK | NENHUM | ORDEM
3 | SUM | 233 | 233 | 234 | 3027841258 | 51001 | 00 | ACEITO | CDBA | CDBA | SIM | 4 | NA | OK | NENHUM | ORDEM
3 | SUM | 234 | 234 | 235 | 3027892257 | 50999 | 00 | ACEITO | 9B94 | 9B94 | SIM | 3 | NA | OK | NENHUM | ORDEM
3 | SUM | 235 | 235 | 236 | 3027943258 | 51001 | 00 | ACEITO | 9685 | 9685 | SIM | 4 | NA | OK | NENHUM | ORDEM
3 | SUM | 236 | 236 | 237 | 3027994257 | 50999 | 00 | ACEITO | FFA5 | FFA5 | SIM | 3 | NA | OK | NENHUM | ORDEM
3 | SUM | 237 | 237 | 238 | 3028045258 | 51001 | 00 | ACEITO | F376 | F376 | SIM | 4 | NA | OK | NENHUM | ORDEM
3 | SUM | 238 | 238 | 239 | 3028096257 | 50999 | 00 | ACEITO | 8ABB | 8ABB | SIM | 3 | NA | OK | NENHUM | ORDEM
3 | SUM | 239 | 239 | 240 | 3028147259 | 51002 | 00 | ACEITO | 4883 | 4883 | SIM | 4 | NA | OK | NENHUM | ORDEM
3 | SUM | 240 | 240 | 241 | 3028198258 | 50999 | 00 | ACEITO | 2EC3 | 2EC3 | SIM | 3 | NA | OK | NENHUM | ORDEM
3 | SUM | 241 | 241 | 242 | 3028249259 | 51001 | 00 | ACEITO | 399E | 399E | SIM | 4 | NA | OK | NENHUM | ORDEM
3 | SUM | 242 | 242 | 243 | 3028300258 | 50999 | 00 | ACEITO | 6737 | 6737 | SIM | 3 | NA | OK | NENHUM | ORDEM
3 | SUM | 243 | 243 | 244 | 3028351259 | 51001 | 00 | ACEITO | 0346 | 0346 | SIM | 4 | NA | OK | NENHUM | ORDEM
3 | SUM | 244 | 244 | 245 | 3028402258 | 50999 | 00 | ACEITO | 07CE | 07CE | SIM | 3 | NA | OK | NENHUM | ORDEM
3 | SUM | 245 | 245 | 246 | 3028453259 | 51001 | 00 | ACEITO | B375 | B375 | SIM | 4 | NA | OK | NENHUM | ORDEM
3 | SUM | 246 | 246 | 247 | 3028504258 | 50999 | 00 | ACEITO | DF72 | DF72 | SIM | 3 | NA | OK | NENHUM | ORDEM
3 | SUM | 247 | 247 | 248 | 3028555259 | 51001 | 00 | ACEITO | BB9B | BB9B | SIM | 4 | NA | OK | NENHUM | ORDEM
3 | SUM | 248 | 248 | 249 | 3028606258 | 50999 | 00 | ACEITO | D857 | D857 | SIM | 3 | NA | OK | NENHUM | ORDEM
3 | SUM | 249 | 249 | 250 | 3028657259 | 51001 | 00 | ACEITO | 227D | 227D | SIM | 4 | NA | OK | NENHUM | ORDEM
3 | SUM | 250 | 250 | 251 | 3028708258 | 50999 | 00 | ACEITO | CF6C | CF6C | SIM | 3 | NA | OK | NENHUM | ORDEM
3 | SUM | 251 | 251 | 252 | 3028759259 | 51001 | 00 | ACEITO | 86F4 | 86F4 | SIM | 4 | NA | OK | NENHUM | ORDEM
3 | SUM | 252 | 252 | 253 | 3028810259 | 51000 | 00 | ACEITO | 948E | 948E | SIM | 3 | NA | OK | NENHUM | ORDEM
3 | SUM | 253 | 253 | 254 | 3028861260 | 51001 | 00 | ACEITO | 72FA | 72FA | SIM | 4 | NA | OK | NENHUM | ORDEM
3 | SUM | 254 | 254 | 255 | 3028912259 | 50999 | 00 | ACEITO | 9F01 | 9F01 | SIM | 3 | NA | OK | NENHUM | ORDEM
3 | SUM | 255 | 255 | 256 | 3028963260 | 51001 | 00 | ACEITO | 8F65 | 8F65 | SIM | 4 | NA | OK | NENHUM | ORDEM
3 | SUM | 256 | 256 | 257 | 3029014259 | 50999 | 00 | ACEITO | 680F | 680F | SIM | 3 | NA | OK | NENHUM | ORDEM
3 | SUM | 257 | 257 | 258 | 3029065260 | 51001 | 00 | ACEITO | 68BF | 68BF | SIM | 4 | NA | OK | NENHUM | ORDEM
3 | SUM | 258 | 258 | 259 | 3029116259 | 50999 | 00 | ACEITO | FD51 | FD51 | SIM | 3 | NA | OK | NENHUM | ORDEM
3 | SUM | 259 | 259 | 260 | 3029167260 | 51001 | 00 | ACEITO | 820B | 820B | SIM | 4 | NA | OK | NENHUM | ORDEM
3 | SUM | 260 | 260 | 261 | 3029218259 | 50999 | 00 | ACEITO | 018E | 018E | SIM | 3 | NA | OK | NENHUM | ORDEM
3 | SUM | 261 | 261 | 262 | 3029269260 | 51001 | 00 | ACEITO | 820D | 820D | SIM | 4 | NA | OK | NENHUM | ORDEM
3 | SUM | 262 | 262 | 263 | 3029320259 | 50999 | 00 | ACEITO | 9509 | 9509 | SIM | 3 | NA | OK | NENHUM | ORDEM
3 | SUM | 263 | 263 | 264 | 3029371260 | 51001 | 00 | ACEITO | CBA0 | CBA0 | SIM | 4 | NA | OK | NENHUM | ORDEM
3 | SUM | 264 | 264 | 265 | 3029422259 | 50999 | 00 | ACEITO | 4E25 | 4E25 | SIM | 3 | NA | OK | NENHUM | ORDEM
3 | SUM | 265 | 265 | 266 | 3029473260 | 51001 | 00 | ACEITO | B12F | B12F | SIM | 4 | NA | OK | NENHUM | ORDEM
3 | SUM | 266 | 266 | 267 | 3029524260 | 51000 | 00 | ACEITO | 3CDF | 3CDF | SIM | 3 | NA | OK | NENHUM | ORDEM
3 | SUM | 267 | 267 | 268 | 3029575261 | 51001 | 00 | ACEITO | DBDB | DBDB | SIM | 4 | NA | OK | NENHUM | ORDEM
3 | SUM | 268 | 268 | 269 | 3029626260 | 50999 | 00 | ACEITO | 0051 | 0051 | SIM | 3 | NA | OK | NENHUM | ORDEM
3 | SUM | 269 | 269 | 270 | 3029677261 | 51001 | 00 | ACEITO | D0BD | D0BD | SIM | 4 | NA | OK | NENHUM | ORDEM
3 | SUM | 270 | 270 | 271 | 3029728260 | 50999 | 00 | ACEITO | 2015 | 2015 | SIM | 3 | NA | OK | NENHUM | ORDEM
3 | SUM | 271 | 271 | 272 | 3029779261 | 51001 | 00 | ACEITO | B03E | B03E | SIM | 4 | NA | OK | NENHUM | ORDEM
3 | SUM | 272 | 272 | 273 | 3029830260 | 50999 | 00 | ACEITO | 57CE | 57CE | SIM | 3 | NA | OK | NENHUM | ORDEM
3 | SUM | 273 | 273 | 274 | 3029881261 | 51001 | 00 | ACEITO | C3D3 | C3D3 | SIM | 4 | NA | OK | NENHUM | ORDEM
3 | SUM | 274 | 274 | 275 | 3029932260 | 50999 | 00 | ACEITO | 6605 | 6605 | SIM | 3 | NA | OK | NENHUM | ORDEM
3 | SUM | 275 | 275 | 276 | 3029983261 | 51001 | 00 | ACEITO | B354 | B354 | SIM | 4 | NA | OK | NENHUM | ORDEM
3 | SUM | 276 | 276 | 277 | 3030034260 | 50999 | 00 | ACEITO | E6AC | E6AC | SIM | 3 | NA | OK | NENHUM | ORDEM
3 | SUM | 277 | 277 | 278 | 3030085261 | 51001 | 00 | ACEITO | B479 | B479 | SIM | 4 | NA | OK | NENHUM | ORDEM
3 | SUM | 278 | 278 | 279 | 3030136260 | 50999 | 00 | ACEITO | 94B4 | 94B4 | SIM | 3 | NA | OK | NENHUM | ORDEM
3 | SUM | 279 | 279 | 280 | 3030187262 | 51002 | 00 | ACEITO | AE35 | AE35 | SIM | 4 | NA | OK | NENHUM | ORDEM
3 | SUM | 280 | 280 | 281 | 3030238261 | 50999 | 00 | ACEITO | F787 | F787 | SIM | 3 | NA | OK | NENHUM | ORDEM
3 | SUM | 281 | 281 | 282 | 3030289262 | 51001 | 00 | ACEITO | C231 | C231 | SIM | 4 | NA | OK | NENHUM | ORDEM
3 | SUM | 282 | 282 | 283 | 3030340261 | 50999 | 00 | ACEITO | 417E | 417E | SIM | 3 | NA | OK | NENHUM | ORDEM
3 | SUM | 283 | 283 | 284 | 3030391262 | 51001 | 00 | ACEITO | 753C | 753C | SIM | 4 | NA | OK | NENHUM | ORDEM
3 | SUM | 284 | 284 | 285 | 3030442261 | 50999 | 00 | ACEITO | D85D | D85D | SIM | 3 | NA | OK | NENHUM | ORDEM
3 | SUM | 285 | 285 | 286 | 3030493262 | 51001 | 00 | ACEITO | DC41 | DC41 | SIM | 4 | NA | OK | NENHUM | ORDEM
3 | SUM | 286 | 286 | 287 | 3030544261 | 50999 | 00 | ACEITO | 74B1 | 74B1 | SIM | 3 | NA | OK | NENHUM | ORDEM
3 | SUM | 287 | 287 | 288 | 3030595262 | 51001 | 00 | ACEITO | 1405 | 1405 | SIM | 4 | NA | OK | NENHUM | ORDEM
3 | SUM | 288 | 288 | 289 | 3030646261 | 50999 | 00 | ACEITO | 9855 | 9855 | SIM | 3 | NA | OK | NENHUM | ORDEM
3 | SUM | 289 | 289 | 290 | 3030697262 | 51001 | 00 | ACEITO | 6B00 | 6B00 | SIM | 4 | NA | OK | NENHUM | ORDEM
3 | SUM | 290 | 290 | 291 | 3030748261 | 50999 | 00 | ACEITO | 27B2 | 27B2 | SIM | 3 | NA | OK | NENHUM | ORDEM
3 | SUM | 291 | 291 | 292 | 3030799262 | 51001 | 00 | ACEITO | 0970 | 0970 | SIM | 4 | NA | OK | NENHUM | ORDEM
3 | SUM | 292 | 292 | 293 | 3030850262 | 51000 | 00 | ACEITO | 83F3 | 83F3 | SIM | 3 | NA | OK | NENHUM | ORDEM
3 | SUM | 293 | 293 | 294 | 3030901263 | 51001 | 00 | ACEITO | 6272 | 6272 | SIM | 4 | NA | OK | NENHUM | ORDEM
3 | SUM | 294 | 294 | 295 | 3030952262 | 50999 | 00 | ACEITO | D872 | D872 | SIM | 3 | NA | OK | NENHUM | ORDEM
3 | SUM | 295 | 295 | 296 | 3031003263 | 51001 | 00 | ACEITO | B5B7 | B5B7 | SIM | 4 | NA | OK | NENHUM | ORDEM
3 | SUM | 296 | 296 | 297 | 3031054262 | 50999 | 00 | ACEITO | 650D | 650D | SIM | 3 | NA | OK | NENHUM | ORDEM
3 | SUM | 297 | 297 | 298 | 3031105263 | 51001 | 00 | ACEITO | 7A49 | 7A49 | SIM | 4 | NA | OK | NENHUM | ORDEM
3 | SUM | 298 | 298 | 299 | 3031156262 | 50999 | 00 | ACEITO | FC67 | FC67 | SIM | 3 | NA | OK | NENHUM | ORDEM
3 | SUM | 299 | 299 | 300 | 3031207263 | 51001 | 00 | ACEITO | 8116 | 8116 | SIM | 4 | NA | OK | NENHUM | ORDEM
3 | SUM | 300 | 300 | 301 | 3031258262 | 50999 | 00 | ACEITO | A9CF | A9CF | SIM | 3 | NA | OK | NENHUM | ORDEM
3 | SUM | 301 | 301 | 302 | 3031309263 | 51001 | 00 | ACEITO | EE6F | EE6F | SIM | 4 | NA | OK | NENHUM | ORDEM
3 | SUM | 302 | 302 | 303 | 3031360262 | 50999 | 00 | ACEITO | A502 | A502 | SIM | 3 | NA | OK | NENHUM | ORDEM
3 | SUM | 303 | 303 | 304 | 3031411263 | 51001 | 00 | ACEITO | 0554 | 0554 | SIM | 4 | NA | OK | NENHUM | ORDEM
3 | SUM | 304 | 304 | 305 | 3031462262 | 50999 | 00 | ACEITO | C5BC | C5BC | SIM | 3 | NA | OK | NENHUM | ORDEM
3 | SUM | 305 | 305 | 306 | 3031513264 | 51002 | 00 | ACEITO | B7F9 | B7F9 | SIM | 4 | NA | OK | NENHUM | ORDEM
3 | SUM | 306 | 306 | 307 | 3031564263 | 50999 | 00 | ACEITO | 92DF | 92DF | SIM | 3 | NA | OK | NENHUM | ORDEM
3 | SUM | 307 | 307 | 308 | 3031615264 | 51001 | 00 | ACEITO | 0CC3 | 0CC3 | SIM | 4 | NA | OK | NENHUM | ORDEM
3 | SUM | 308 | 308 | 309 | 3031666263 | 50999 | 00 | ACEITO | 45A2 | 45A2 | SIM | 3 | NA | OK | NENHUM | ORDEM
3 | SUM | 309 | 309 | 310 | 3031717264 | 51001 | 00 | ACEITO | B191 | B191 | SIM | 4 | NA | OK | NENHUM | ORDEM
3 | SUM | 310 | 310 | 311 | 3031768263 | 50999 | 00 | ACEITO | 6EEF | 6EEF | SIM | 3 | NA | OK | NENHUM | ORDEM
3 | SUM | 311 | 311 | 312 | 3031819264 | 51001 | 00 | ACEITO | 9BDB | 9BDB | SIM | 4 | NA | OK | NENHUM | ORDEM
3 | SUM | 312 | 312 | 313 | 3031870263 | 50999 | 00 | ACEITO | C56B | C56B | SIM | 3 | NA | OK | NENHUM | ORDEM
3 | SUM | 313 | 313 | 314 | 3031921264 | 51001 | 00 | ACEITO | BEEF | BEEF | SIM | 4 | NA | OK | NENHUM | ORDEM
3 | SUM | 314 | 314 | 315 | 3031972263 | 50999 | 00 | ACEITO | A9FF | A9FF | SIM | 3 | NA | OK | NENHUM | ORDEM
3 | SUM | 315 | 315 | 316 | 3032023264 | 51001 | 00 | ACEITO | 39AB | 39AB | SIM | 4 | NA | OK | NENHUM | ORDEM
3 | SUM | 316 | 316 | 317 | 3032074263 | 50999 | 00 | ACEITO | DC90 | DC90 | SIM | 3 | NA | OK | NENHUM | ORDEM
3 | SUM | 317 | 317 | 318 | 3032125264 | 51001 | 00 | ACEITO | 6556 | 6556 | SIM | 4 | NA | OK | NENHUM | ORDEM
3 | SUM | 318 | 318 | 319 | 3032176264 | 51000 | 00 | ACEITO | EC58 | EC58 | SIM | 3 | NA | OK | NENHUM | ORDEM
3 | SUM | 319 | 319 | 320 | 3032227265 | 51001 | 00 | ACEITO | F1EC | F1EC | SIM | 4 | NA | OK | NENHUM | ORDEM
3 | SUM | 320 | 320 | 321 | 3032278264 | 50999 | 00 | ACEITO | 47EE | 47EE | SIM | 3 | NA | OK | NENHUM | ORDEM
3 | SUM | 321 | 321 | 322 | 3032329265 | 51001 | 00 | ACEITO | E6F8 | E6F8 | SIM | 4 | NA | OK | NENHUM | ORDEM
3 | SUM | 322 | 322 | 323 | 3032380264 | 50999 | 00 | ACEITO | BC28 | BC28 | SIM | 3 | NA | OK | NENHUM | ORDEM
3 | SUM | 323 | 323 | 324 | 3032431265 | 51001 | 00 | ACEITO | 3BBC | 3BBC | SIM | 4 | NA | OK | NENHUM | ORDEM
3 | SUM | 324 | 324 | 325 | 3032482264 | 50999 | 00 | ACEITO | 30C6 | 30C6 | SIM | 3 | NA | OK | NENHUM | ORDEM
3 | SUM | 325 | 325 | 326 | 3032533265 | 51001 | 00 | ACEITO | 2848 | 2848 | SIM | 4 | NA | OK | NENHUM | ORDEM
3 | SUM | 326 | 326 | 327 | 3032584264 | 50999 | 00 | ACEITO | F0D1 | F0D1 | SIM | 3 | NA | OK | NENHUM | ORDEM
3 | SUM | 327 | 327 | 328 | 3032635265 | 51001 | 00 | ACEITO | 765A | 765A | SIM | 4 | NA | OK | NENHUM | ORDEM
3 | SUM | 328 | 328 | 329 | 3032686264 | 50999 | 00 | ACEITO | 15BF | 15BF | SIM | 3 | NA | OK | NENHUM | ORDEM
3 | SUM | 329 | 329 | 330 | 3032737265 | 51001 | 00 | ACEITO | 76B8 | 76B8 | SIM | 4 | NA | OK | NENHUM | ORDEM
3 | SUM | 330 | 330 | 331 | 3032788264 | 50999 | 00 | ACEITO | D345 | D345 | SIM | 3 | NA | OK | NENHUM | ORDEM
3 | SUM | 331 | 331 | 332 | 3032839266 | 51002 | 00 | ACEITO | 87C1 | 87C1 | SIM | 4 | NA | OK | NENHUM | ORDEM
3 | SUM | 332 | 332 | 333 | 3032890265 | 50999 | 00 | ACEITO | C321 | C321 | SIM | 3 | NA | OK | NENHUM | ORDEM
3 | SUM | 333 | 333 | 334 | 3032941266 | 51001 | 00 | ACEITO | 69F2 | 69F2 | SIM | 4 | NA | OK | NENHUM | ORDEM
3 | SUM | 334 | 334 | 335 | 3032992265 | 50999 | 00 | ACEITO | 15D3 | 15D3 | SIM | 3 | NA | OK | NENHUM | ORDEM
3 | SUM | 335 | 335 | 336 | 3033043266 | 51001 | 00 | ACEITO | EEE4 | EEE4 | SIM | 4 | NA | OK | NENHUM | ORDEM
3 | SUM | 336 | 336 | 337 | 3033094265 | 50999 | 00 | ACEITO | 71EA | 71EA | SIM | 3 | NA | OK | NENHUM | ORDEM
3 | SUM | 337 | 337 | 338 | 3033145266 | 51001 | 00 | ACEITO | 5C14 | 5C14 | SIM | 4 | NA | OK | NENHUM | ORDEM
3 | SUM | 338 | 338 | 339 | 3033196265 | 50999 | 00 | ACEITO | 6AB0 | 6AB0 | SIM | 3 | NA | OK | NENHUM | ORDEM
3 | SUM | 339 | 339 | 340 | 3033247266 | 51001 | 00 | ACEITO | BFD6 | BFD6 | SIM | 4 | NA | OK | NENHUM | ORDEM
3 | SUM | 340 | 340 | 341 | 3033298265 | 50999 | 00 | ACEITO | C35B | C35B | SIM | 3 | NA | OK | NENHUM | ORDEM
3 | SUM | 341 | 341 | 342 | 3033349266 | 51001 | 00 | ACEITO | 59D1 | 59D1 | SIM | 4 | NA | OK | NENHUM | ORDEM
3 | SUM | 342 | 342 | 343 | 3033400265 | 50999 | 00 | ACEITO | 1AC4 | 1AC4 | SIM | 3 | NA | OK | NENHUM | ORDEM
3 | SUM | 343 | 343 | 344 | 3033451266 | 51001 | 00 | ACEITO | 9558 | 9558 | SIM | 4 | NA | OK | NENHUM | ORDEM
3 | SUM | 344 | 344 | 345 | 3033502266 | 51000 | 00 | ACEITO | C1AF | C1AF | SIM | 3 | NA | OK | NENHUM | ORDEM
3 | SUM | 345 | 345 | 346 | 3033553267 | 51001 | 00 | ACEITO | 7B4A | 7B4A | SIM | 4 | NA | OK | NENHUM | ORDEM
3 | SUM | 346 | 346 | 347 | 3033604266 | 50999 | 00 | ACEITO | 608F | 608F | SIM | 3 | NA | OK | NENHUM | ORDEM
3 | SUM | 347 | 347 | 348 | 3033655267 | 51001 | 00 | ACEITO | 6A66 | 6A66 | SIM | 4 | NA | OK | NENHUM | ORDEM
3 | SUM | 348 | 348 | 349 | 3033706266 | 50999 | 00 | ACEITO | A34F | A34F | SIM | 3 | NA | OK | NENHUM | ORDEM
3 | SUM | 349 | 349 | 350 | 3033757267 | 51001 | 00 | ACEITO | 56A2 | 56A2 | SIM | 4 | NA | OK | NENHUM | ORDEM
3 | SUM | 350 | 350 | 351 | 3033808266 | 50999 | 00 | ACEITO | 166B | 166B | SIM | 3 | NA | OK | NENHUM | ORDEM
3 | SUM | 351 | 351 | 352 | 3033859267 | 51001 | 00 | ACEITO | 8BF9 | 8BF9 | SIM | 4 | NA | OK | NENHUM | ORDEM
3 | SUM | 352 | 352 | 353 | 3033910266 | 50999 | 00 | ACEITO | 2948 | 2948 | SIM | 3 | NA | OK | NENHUM | ORDEM
3 | SUM | 353 | 353 | 354 | 3033961267 | 51001 | 00 | ACEITO | 89C1 | 89C1 | SIM | 4 | NA | OK | NENHUM | ORDEM
3 | SUM | 354 | 354 | 355 | 3034012266 | 50999 | 00 | ACEITO | A968 | A968 | SIM | 3 | NA | OK | NENHUM | ORDEM
3 | SUM | 355 | 355 | 356 | 3034063267 | 51001 | 00 | ACEITO | 6C38 | 6C38 | SIM | 4 | NA | OK | NENHUM | ORDEM
3 | SUM | 356 | 356 | 357 | 3034114266 | 50999 | 00 | ACEITO | 33BF | 33BF | SIM | 3 | NA | OK | NENHUM | ORDEM
3 | SUM | 357 | 357 | 358 | 3034165268 | 51002 | 00 | ACEITO | 9321 | 9321 | SIM | 4 | NA | OK | NENHUM | ORDEM
3 | SUM | 358 | 358 | 359 | 3034216267 | 50999 | 00 | ACEITO | 62CA | 62CA | SIM | 3 | NA | OK | NENHUM | ORDEM
3 | SUM | 359 | 359 | 360 | 3034267268 | 51001 | 00 | ACEITO | 3E14 | 3E14 | SIM | 4 | NA | OK | NENHUM | ORDEM
3 | SUM | 360 | 360 | 361 | 3034318267 | 50999 | 00 | ACEITO | 57AA | 57AA | SIM | 3 | NA | OK | NENHUM | ORDEM
3 | SUM | 361 | 361 | 362 | 3034369268 | 51001 | 00 | ACEITO | 4F74 | 4F74 | SIM | 4 | NA | OK | NENHUM | ORDEM
3 | SUM | 362 | 362 | 363 | 3034420267 | 50999 | 00 | ACEITO | A585 | A585 | SIM | 3 | NA | OK | NENHUM | ORDEM
3 | SUM | 363 | 363 | 364 | 3034471268 | 51001 | 00 | ACEITO | 427C | 427C | SIM | 4 | NA | OK | NENHUM | ORDEM
3 | SUM | 364 | 364 | 365 | 3034522267 | 50999 | 00 | ACEITO | 9110 | 9110 | SIM | 3 | NA | OK | NENHUM | ORDEM
3 | SUM | 365 | 365 | 366 | 3034573268 | 51001 | 00 | ACEITO | 91BA | 91BA | SIM | 4 | NA | OK | NENHUM | ORDEM
3 | SUM | 366 | 366 | 367 | 3034624267 | 50999 | 00 | ACEITO | 581D | 581D | SIM | 3 | NA | OK | NENHUM | ORDEM
3 | SUM | 367 | 367 | 368 | 3034675268 | 51001 | 00 | ACEITO | 6035 | 6035 | SIM | 4 | NA | OK | NENHUM | ORDEM
3 | SUM | 368 | 368 | 369 | 3034726267 | 50999 | 00 | ACEITO | 61F9 | 61F9 | SIM | 3 | NA | OK | NENHUM | ORDEM
3 | SUM | 369 | 369 | 370 | 3034777268 | 51001 | 00 | ACEITO | 0C76 | 0C76 | SIM | 4 | NA | OK | NENHUM | ORDEM
3 | SUM | 370 | 370 | 371 | 3034828268 | 51000 | 00 | ACEITO | F188 | F188 | SIM | 3 | NA | OK | NENHUM | ORDEM
3 | SUM | 371 | 371 | 372 | 3034879269 | 51001 | 00 | ACEITO | EC90 | EC90 | SIM | 4 | NA | OK | NENHUM | ORDEM
3 | SUM | 372 | 372 | 373 | 3034930268 | 50999 | 00 | ACEITO | E707 | E707 | SIM | 3 | NA | OK | NENHUM | ORDEM
3 | SUM | 373 | 373 | 374 | 3034981269 | 51001 | 00 | ACEITO | 9BDE | 9BDE | SIM | 4 | NA | OK | NENHUM | ORDEM
3 | SUM | 374 | 374 | 375 | 3035032268 | 50999 | 00 | ACEITO | 53DF | 53DF | SIM | 3 | NA | OK | NENHUM | ORDEM
3 | SUM | 375 | 375 | 376 | 3035083269 | 51001 | 00 | ACEITO | 756E | 756E | SIM | 4 | NA | OK | NENHUM | ORDEM
3 | SUM | 376 | 376 | 377 | 3035134268 | 50999 | 00 | ACEITO | AAFC | AAFC | SIM | 3 | NA | OK | NENHUM | ORDEM
3 | SUM | 377 | 377 | 378 | 3035185269 | 51001 | 00 | ACEITO | 8F2B | 8F2B | SIM | 4 | NA | OK | NENHUM | ORDEM
3 | SUM | 378 | 378 | 379 | 3035236268 | 50999 | 00 | ACEITO | 47DF | 47DF | SIM | 3 | NA | OK | NENHUM | ORDEM
3 | SUM | 379 | 379 | 380 | 3035287269 | 51001 | 00 | ACEITO | 6392 | 6392 | SIM | 4 | NA | OK | NENHUM | ORDEM
3 | SUM | 380 | 380 | 381 | 3035338268 | 50999 | 00 | ACEITO | BAE2 | BAE2 | SIM | 3 | NA | OK | NENHUM | ORDEM
3 | SUM | 381 | 381 | 382 | 3035389269 | 51001 | 00 | ACEITO | 2F13 | 2F13 | SIM | 4 | NA | OK | NENHUM | ORDEM
3 | SUM | 382 | 382 | 383 | 3035440268 | 50999 | 00 | ACEITO | 0BC8 | 0BC8 | SIM | 3 | NA | OK | NENHUM | ORDEM
3 | SUM | 383 | 383 | 384 | 3035491270 | 51002 | 00 | ACEITO | 1145 | 1145 | SIM | 4 | NA | OK | NENHUM | ORDEM
3 | SUM | 384 | 384 | 385 | 3035542269 | 50999 | 00 | ACEITO | 5169 | 5169 | SIM | 3 | NA | OK | NENHUM | ORDEM
3 | SUM | 385 | 385 | 386 | 3035593270 | 51001 | 00 | ACEITO | 2182 | 2182 | SIM | 4 | NA | OK | NENHUM | ORDEM
3 | SUM | 386 | 386 | 387 | 3035644269 | 50999 | 00 | ACEITO | 67C9 | 67C9 | SIM | 3 | NA | OK | NENHUM | ORDEM
3 | SUM | 387 | 387 | 388 | 3035695270 | 51001 | 00 | ACEITO | BF36 | BF36 | SIM | 4 | NA | OK | NENHUM | ORDEM
3 | SUM | 388 | 388 | 389 | 3035746269 | 50999 | 00 | ACEITO | 8220 | 8220 | SIM | 3 | NA | OK | NENHUM | ORDEM
3 | SUM | 389 | 389 | 390 | 3035797270 | 51001 | 00 | ACEITO | C66E | C66E | SIM | 4 | NA | OK | NENHUM | ORDEM
3 | SUM | 390 | 390 | 391 | 3035848269 | 50999 | 00 | ACEITO | 9BC2 | 9BC2 | SIM | 3 | NA | OK | NENHUM | ORDEM
3 | SUM | 391 | 391 | 392 | 3035899270 | 51001 | 00 | ACEITO | BD2E | BD2E | SIM | 4 | NA | OK | NENHUM | ORDEM
3 | SUM | 392 | 392 | 393 | 3035950269 | 50999 | 00 | ACEITO | 1BE7 | 1BE7 | SIM | 3 | NA | OK | NENHUM | ORDEM
3 | SUM | 393 | 393 | 394 | 3036001270 | 51001 | 00 | ACEITO | BB2F | BB2F | SIM | 4 | NA | OK | NENHUM | ORDEM
3 | SUM | 394 | 394 | 395 | 3036052269 | 50999 | 00 | ACEITO | E1D5 | E1D5 | SIM | 3 | NA | OK | NENHUM | ORDEM
3 | SUM | 395 | 395 | 396 | 3036103270 | 51001 | 00 | ACEITO | BFEC | BFEC | SIM | 4 | NA | OK | NENHUM | ORDEM
3 | SUM | 396 | 396 | 397 | 3036154270 | 51000 | 00 | ACEITO | 9A7E | 9A7E | SIM | 3 | NA | OK | NENHUM | ORDEM
3 | SUM | 397 | 397 | 398 | 3036205271 | 51001 | 00 | ACEITO | FA2A | FA2A | SIM | 4 | NA | OK | NENHUM | ORDEM
3 | SUM | 398 | 398 | 399 | 3036256270 | 50999 | 00 | ACEITO | E6D4 | E6D4 | SIM | 3 | NA | OK | NENHUM | ORDEM
3 | SUM | 399 | 399 | 400 | 3036307271 | 51001 | 00 | ACEITO | 5FF8 | 5FF8 | SIM | 4 | NA | OK | NENHUM | ORDEM
3 | SUM | 400 | 400 | 401 | 3036358270 | 50999 | 00 | ACEITO | 1AB3 | 1AB3 | SIM | 3 | NA | OK | NENHUM | ORDEM
3 | SUM | 401 | 401 | 402 | 3036409271 | 51001 | 00 | ACEITO | 7998 | 7998 | SIM | 4 | NA | OK | NENHUM | ORDEM
3 | SUM | 402 | 402 | 403 | 3036460270 | 50999 | 00 | ACEITO | 9599 | 9599 | SIM | 3 | NA | OK | NENHUM | ORDEM
3 | SUM | 403 | 403 | 404 | 3036511271 | 51001 | 00 | ACEITO | E657 | E657 | SIM | 4 | NA | OK | NENHUM | ORDEM
3 | SUM | 404 | 404 | 405 | 3036562270 | 50999 | 00 | ACEITO | 177E | 177E | SIM | 3 | NA | OK | NENHUM | ORDEM
3 | SUM | 405 | 405 | 406 | 3036613271 | 51001 | 00 | ACEITO | A963 | A963 | SIM | 4 | NA | OK | NENHUM | ORDEM
3 | SUM | 406 | 406 | 407 | 3036664270 | 50999 | 00 | ACEITO | FFE9 | FFE9 | SIM | 3 | NA | OK | NENHUM | ORDEM
3 | SUM | 407 | 407 | 408 | 3036715271 | 51001 | 00 | ACEITO | 3237 | 3237 | SIM | 4 | NA | OK | NENHUM | ORDEM
3 | SUM | 408 | 408 | 409 | 3036766270 | 50999 | 00 | ACEITO | 2318 | 2318 | SIM | 3 | NA | OK | NENHUM | ORDEM
3 | SUM | 409 | 409 | 410 | 3036817272 | 51002 | 00 | ACEITO | 87D7 | 87D7 | SIM | 4 | NA | OK | NENHUM | ORDEM
3 | SUM | 410 | 410 | 411 | 3036868271 | 50999 | 00 | ACEITO | 6FDC | 6FDC | SIM | 3 | NA | OK | NENHUM | ORDEM
3 | SUM | 411 | 411 | 412 | 3036919272 | 51001 | 00 | ACEITO | 5901 | 5901 | SIM | 4 | NA | OK | NENHUM | ORDEM
3 | SUM | 412 | 412 | 413 | 3036970271 | 50999 | 00 | ACEITO | 6551 | 6551 | SIM | 3 | NA | OK | NENHUM | ORDEM
3 | SUM | 413 | 413 | 414 | 3037021272 | 51001 | 00 | ACEITO | 61EB | 61EB | SIM | 4 | NA | OK | NENHUM | ORDEM
3 | SUM | 414 | 414 | 415 | 3037072271 | 50999 | 00 | ACEITO | 1B8F | 1B8F | SIM | 3 | NA | OK | NENHUM | ORDEM
3 | SUM | 415 | 415 | 416 | 3037123272 | 51001 | 00 | ACEITO | D7A9 | D7A9 | SIM | 4 | NA | OK | NENHUM | ORDEM
3 | SUM | 416 | 416 | 417 | 3037174271 | 50999 | 00 | ACEITO | 7CE3 | 7CE3 | SIM | 3 | NA | OK | NENHUM | ORDEM
3 | SUM | 417 | 417 | 418 | 3037225272 | 51001 | 00 | ACEITO | 0A08 | 0A08 | SIM | 4 | NA | OK | NENHUM | ORDEM
3 | SUM | 418 | 418 | 419 | 3037276271 | 50999 | 00 | ACEITO | 357D | 357D | SIM | 3 | NA | OK | NENHUM | ORDEM
3 | SUM | 419 | 419 | 420 | 3037327272 | 51001 | 00 | ACEITO | 22BD | 22BD | SIM | 4 | NA | OK | NENHUM | ORDEM
3 | SUM | 420 | 420 | 421 | 3037378271 | 50999 | 00 | ACEITO | 2A63 | 2A63 | SIM | 3 | NA | OK | NENHUM | ORDEM
3 | SUM | 421 | 421 | 422 | 3037429272 | 51001 | 00 | ACEITO | 68B2 | 68B2 | SIM | 4 | NA | OK | NENHUM | ORDEM
3 | SUM | 422 | 422 | 423 | 3037480272 | 51000 | 00 | ACEITO | 407C | 407C | SIM | 3 | NA | OK | NENHUM | ORDEM
3 | SUM | 423 | 423 | 424 | 3037531273 | 51001 | 00 | ACEITO | FC7E | FC7E | SIM | 4 | NA | OK | NENHUM | ORDEM
3 | SUM | 424 | 424 | 425 | 3037582272 | 50999 | 00 | ACEITO | FCC5 | FCC5 | SIM | 3 | NA | OK | NENHUM | ORDEM
3 | SUM | 425 | 425 | 426 | 3037633273 | 51001 | 00 | ACEITO | 4989 | 4989 | SIM | 4 | NA | OK | NENHUM | ORDEM
3 | SUM | 426 | 426 | 427 | 3037684272 | 50999 | 00 | ACEITO | 2863 | 2863 | SIM | 3 | NA | OK | NENHUM | ORDEM
3 | SUM | 427 | 427 | 428 | 3037735273 | 51001 | 00 | ACEITO | 8D7E | 8D7E | SIM | 4 | NA | OK | NENHUM | ORDEM
3 | SUM | 428 | 428 | 429 | 3037786272 | 50999 | 00 | ACEITO | 4B7F | 4B7F | SIM | 3 | NA | OK | NENHUM | ORDEM
3 | SUM | 429 | 429 | 430 | 3037837273 | 51001 | 00 | ACEITO | 5074 | 5074 | SIM | 4 | NA | OK | NENHUM | ORDEM
3 | SUM | 430 | 430 | 431 | 3037888272 | 50999 | 00 | ACEITO | 71A5 | 71A5 | SIM | 3 | NA | OK | NENHUM | ORDEM
3 | SUM | 431 | 431 | 432 | 3037939273 | 51001 | 00 | ACEITO | E4AF | E4AF | SIM | 4 | NA | OK | NENHUM | ORDEM
3 | SUM | 432 | 432 | 433 | 3037990272 | 50999 | 00 | ACEITO | F1B2 | F1B2 | SIM | 3 | NA | OK | NENHUM | ORDEM
3 | SUM | 433 | 433 | 434 | 3038041273 | 51001 | 00 | ACEITO | 9A54 | 9A54 | SIM | 4 | NA | OK | NENHUM | ORDEM
3 | SUM | 434 | 434 | 435 | 3038092272 | 50999 | 00 | ACEITO | 4505 | 4505 | SIM | 3 | NA | OK | NENHUM | ORDEM
3 | SUM | 435 | 435 | 436 | 3038143274 | 51002 | 00 | ACEITO | 39B2 | 39B2 | SIM | 4 | NA | OK | NENHUM | ORDEM
3 | SUM | 436 | 436 | 437 | 3038194273 | 50999 | 00 | ACEITO | 6F75 | 6F75 | SIM | 3 | NA | OK | NENHUM | ORDEM
3 | SUM | 437 | 437 | 438 | 3038245274 | 51001 | 00 | ACEITO | C21E | C21E | SIM | 4 | NA | OK | NENHUM | ORDEM
3 | SUM | 438 | 438 | 439 | 3038296273 | 50999 | 00 | ACEITO | E3EF | E3EF | SIM | 3 | NA | OK | NENHUM | ORDEM
3 | SUM | 439 | 439 | 440 | 3038347274 | 51001 | 00 | ACEITO | 5CDF | 5CDF | SIM | 4 | NA | OK | NENHUM | ORDEM
3 | SUM | 440 | 440 | 441 | 3038398273 | 50999 | 00 | ACEITO | 7902 | 7902 | SIM | 3 | NA | OK | NENHUM | ORDEM
3 | SUM | 441 | 441 | 442 | 3038449274 | 51001 | 00 | ACEITO | AA0B | AA0B | SIM | 4 | NA | OK | NENHUM | ORDEM
3 | SUM | 442 | 442 | 443 | 3038500273 | 50999 | 00 | ACEITO | 87B1 | 87B1 | SIM | 3 | NA | OK | NENHUM | ORDEM
3 | SUM | 443 | 443 | 444 | 3038551274 | 51001 | 00 | ACEITO | 6733 | 6733 | SIM | 4 | NA | OK | NENHUM | ORDEM
3 | SUM | 444 | 444 | 445 | 3038602273 | 50999 | 00 | ACEITO | 331B | 331B | SIM | 3 | NA | OK | NENHUM | ORDEM
3 | SUM | 445 | 445 | 446 | 3038653274 | 51001 | 00 | ACEITO | 7EC2 | 7EC2 | SIM | 4 | NA | OK | NENHUM | ORDEM
3 | SUM | 446 | 446 | 447 | 3038704273 | 50999 | 00 | ACEITO | 2567 | 2567 | SIM | 3 | NA | OK | NENHUM | ORDEM
3 | SUM | 447 | 447 | 448 | 3038755274 | 51001 | 00 | ACEITO | 1A2B | 1A2B | SIM | 4 | NA | OK | NENHUM | ORDEM
3 | SUM | 448 | 448 | 449 | 3038806274 | 51000 | 00 | ACEITO | AB94 | AB94 | SIM | 3 | NA | OK | NENHUM | ORDEM
3 | SUM | 449 | 449 | 450 | 3038857275 | 51001 | 00 | ACEITO | F93B | F93B | SIM | 4 | NA | OK | NENHUM | ORDEM
3 | SUM | 450 | 450 | 451 | 3038908274 | 50999 | 00 | ACEITO | 04C9 | 04C9 | SIM | 3 | NA | OK | NENHUM | ORDEM
3 | SUM | 451 | 451 | 452 | 3038959275 | 51001 | 00 | ACEITO | 9443 | 9443 | SIM | 4 | NA | OK | NENHUM | ORDEM
3 | SUM | 452 | 452 | 453 | 3039010274 | 50999 | 00 | ACEITO | 80E4 | 80E4 | SIM | 3 | NA | OK | NENHUM | ORDEM
3 | SUM | 453 | 453 | 454 | 3039061275 | 51001 | 00 | ACEITO | 2926 | 2926 | SIM | 4 | NA | OK | NENHUM | ORDEM
3 | SUM | 454 | 454 | 455 | 3039112274 | 50999 | 00 | ACEITO | 2D93 | 2D93 | SIM | 3 | NA | OK | NENHUM | ORDEM
3 | SUM | 455 | 455 | 456 | 3039163275 | 51001 | 00 | ACEITO | 7CD9 | 7CD9 | SIM | 4 | NA | OK | NENHUM | ORDEM
3 | SUM | 456 | 456 | 457 | 3039214274 | 50999 | 00 | ACEITO | AF54 | AF54 | SIM | 3 | NA | OK | NENHUM | ORDEM
3 | SUM | 457 | 457 | 458 | 3039265275 | 51001 | 00 | ACEITO | 45C2 | 45C2 | SIM | 4 | NA | OK | NENHUM | ORDEM
3 | SUM | 458 | 458 | 459 | 3039316274 | 50999 | 00 | ACEITO | 26CC | 26CC | SIM | 3 | NA | OK | NENHUM | ORDEM
3 | SUM | 459 | 459 | 460 | 3039367275 | 51001 | 00 | ACEITO | 8CE4 | 8CE4 | SIM | 4 | NA | OK | NENHUM | ORDEM
3 | SUM | 460 | 460 | 461 | 3039418274 | 50999 | 00 | ACEITO | 3FC7 | 3FC7 | SIM | 3 | NA | OK | NENHUM | ORDEM
3 | SUM | 461 | 461 | 462 | 3039469276 | 51002 | 00 | ACEITO | B72B | B72B | SIM | 4 | NA | OK | NENHUM | ORDEM
3 | SUM | 462 | 462 | 463 | 3039520275 | 50999 | 00 | ACEITO | D7D8 | D7D8 | SIM | 3 | NA | OK | NENHUM | ORDEM
3 | SUM | 463 | 463 | 464 | 3039571276 | 51001 | 00 | ACEITO | 46D7 | 46D7 | SIM | 4 | NA | OK | NENHUM | ORDEM
3 | SUM | 464 | 464 | 465 | 3039622275 | 50999 | 00 | ACEITO | 4769 | 4769 | SIM | 3 | NA | OK | NENHUM | ORDEM
3 | SUM | 465 | 465 | 466 | 3039673276 | 51001 | 00 | ACEITO | E45E | E45E | SIM | 4 | NA | OK | NENHUM | ORDEM
3 | SUM | 466 | 466 | 467 | 3039724275 | 50999 | 00 | ACEITO | 6550 | 6550 | SIM | 3 | NA | OK | NENHUM | ORDEM
3 | SUM | 467 | 467 | 468 | 3039775276 | 51001 | 00 | ACEITO | 0A8C | 0A8C | SIM | 4 | NA | OK | NENHUM | ORDEM
3 | SUM | 468 | 468 | 469 | 3039826275 | 50999 | 00 | ACEITO | 9476 | 9476 | SIM | 3 | NA | OK | NENHUM | ORDEM
3 | SUM | 469 | 469 | 470 | 3039877276 | 51001 | 00 | ACEITO | 09FD | 09FD | SIM | 4 | NA | OK | NENHUM | ORDEM
3 | SUM | 470 | 470 | 471 | 3039928275 | 50999 | 00 | ACEITO | 5F7A | 5F7A | SIM | 3 | NA | OK | NENHUM | ORDEM
3 | SUM | 471 | 471 | 472 | 3039979276 | 51001 | 00 | ACEITO | F245 | F245 | SIM | 4 | NA | OK | NENHUM | ORDEM
3 | SUM | 472 | 472 | 473 | 3040030275 | 50999 | 00 | ACEITO | 9312 | 9312 | SIM | 3 | NA | OK | NENHUM | ORDEM
3 | SUM | 473 | 473 | 474 | 3040081276 | 51001 | 00 | ACEITO | 9278 | 9278 | SIM | 4 | NA | OK | NENHUM | ORDEM
3 | SUM | 474 | 474 | 475 | 3040132276 | 51000 | 00 | ACEITO | C7F7 | C7F7 | SIM | 3 | NA | OK | NENHUM | ORDEM
3 | SUM | 475 | 475 | 476 | 3040183277 | 51001 | 00 | ACEITO | 2368 | 2368 | SIM | 4 | NA | OK | NENHUM | ORDEM
3 | SUM | 476 | 476 | 477 | 3040234276 | 50999 | 00 | ACEITO | 31CF | 31CF | SIM | 3 | NA | OK | NENHUM | ORDEM
3 | SUM | 477 | 477 | 478 | 3040285277 | 51001 | 00 | ACEITO | 2359 | 2359 | SIM | 4 | NA | OK | NENHUM | ORDEM
3 | SUM | 478 | 478 | 479 | 3040336276 | 50999 | 00 | ACEITO | DB8A | DB8A | SIM | 3 | NA | OK | NENHUM | ORDEM
3 | SUM | 479 | 479 | 480 | 3040387277 | 51001 | 00 | ACEITO | A437 | A437 | SIM | 4 | NA | OK | NENHUM | ORDEM
3 | SUM | 480 | 480 | 481 | 3040438276 | 50999 | 00 | ACEITO | 44C3 | 44C3 | SIM | 3 | NA | OK | NENHUM | ORDEM
3 | SUM | 481 | 481 | 482 | 3040489277 | 51001 | 00 | ACEITO | 0FBD | 0FBD | SIM | 4 | NA | OK | NENHUM | ORDEM
3 | SUM | 482 | 482 | 483 | 3040540276 | 50999 | 00 | ACEITO | BE76 | BE76 | SIM | 3 | NA | OK | NENHUM | ORDEM
3 | SUM | 483 | 483 | 484 | 3040591277 | 51001 | 00 | ACEITO | CCEE | CCEE | SIM | 4 | NA | OK | NENHUM | ORDEM
3 | SUM | 484 | 484 | 485 | 3040642276 | 50999 | 00 | ACEITO | DB77 | DB77 | SIM | 3 | NA | OK | NENHUM | ORDEM
3 | SUM | 485 | 485 | 486 | 3040693277 | 51001 | 00 | ACEITO | 8742 | 8742 | SIM | 4 | NA | OK | NENHUM | ORDEM
3 | SUM | 486 | 486 | 487 | 3040744276 | 50999 | 00 | ACEITO | DEB8 | DEB8 | SIM | 3 | NA | OK | NENHUM | ORDEM
3 | SUM | 487 | 487 | 488 | 3040795278 | 51002 | 00 | ACEITO | 0E26 | 0E26 | SIM | 4 | NA | OK | NENHUM | ORDEM
3 | SUM | 488 | 488 | 489 | 3040846277 | 50999 | 00 | ACEITO | 559C | 559C | SIM | 3 | NA | OK | NENHUM | ORDEM
3 | SUM | 489 | 489 | 490 | 3040897278 | 51001 | 00 | ACEITO | 2A91 | 2A91 | SIM | 4 | NA | OK | NENHUM | ORDEM
3 | SUM | 490 | 490 | 491 | 3040948277 | 50999 | 00 | ACEITO | 2400 | 2400 | SIM | 3 | NA | OK | NENHUM | ORDEM
3 | SUM | 491 | 491 | 492 | 3040999278 | 51001 | 00 | ACEITO | 80AB | 80AB | SIM | 4 | NA | OK | NENHUM | ORDEM
3 | SUM | 492 | 492 | 493 | 3041050277 | 50999 | 00 | ACEITO | A06F | A06F | SIM | 3 | NA | OK | NENHUM | ORDEM
3 | SUM | 493 | 493 | 494 | 3041101278 | 51001 | 00 | ACEITO | 7ACF | 7ACF | SIM | 4 | NA | OK | NENHUM | ORDEM
3 | SUM | 494 | 494 | 495 | 3041152277 | 50999 | 00 | ACEITO | 3EAC | 3EAC | SIM | 3 | NA | OK | NENHUM | ORDEM
3 | SUM | 495 | 495 | 496 | 3041203278 | 51001 | 00 | ACEITO | C67A | C67A | SIM | 4 | NA | OK | NENHUM | ORDEM
3 | SUM | 496 | 496 | 497 | 3041254277 | 50999 | 00 | ACEITO | D4C6 | D4C6 | SIM | 3 | NA | OK | NENHUM | ORDEM
3 | SUM | 497 | 497 | 498 | 3041305278 | 51001 | 00 | ACEITO | C10D | C10D | SIM | 4 | NA | OK | NENHUM | ORDEM
3 | SUM | 498 | 498 | 499 | 3041356277 | 50999 | 00 | ACEITO | DE11 | DE11 | SIM | 3 | NA | OK | NENHUM | ORDEM
3 | SUM | 499 | 499 | 500 | 3041407278 | 51001 | 00 | ACEITO | C1C7 | C1C7 | SIM | 4 | NA | OK | NENHUM | ORDEM
3 | SUM | 500 | 500 | 501 | 3041458278 | 51000 | 00 | ACEITO | 2A91 | 2A91 | SIM | 3 | NA | OK | NENHUM | ORDEM
3 | SUM | 501 | 501 | 502 | 3041509279 | 51001 | 00 | ACEITO | 6D15 | 6D15 | SIM | 4 | NA | OK | NENHUM | ORDEM
3 | SUM | 502 | 502 | 503 | 3041560278 | 50999 | 00 | ACEITO | 4337 | 4337 | SIM | 3 | NA | OK | NENHUM | ORDEM
3 | SUM | 503 | 503 | 504 | 3041611279 | 51001 | 00 | ACEITO | B7EC | B7EC | SIM | 4 | NA | OK | NENHUM | ORDEM
3 | SUM | 504 | 504 | 505 | 3041662278 | 50999 | 00 | ACEITO | C321 | C321 | SIM | 3 | NA | OK | NENHUM | ORDEM
3 | SUM | 505 | 505 | 506 | 3041713279 | 51001 | 00 | ACEITO | 9324 | 9324 | SIM | 4 | NA | OK | NENHUM | ORDEM
3 | SUM | 506 | 506 | 507 | 3041764278 | 50999 | 00 | ACEITO | 920A | 920A | SIM | 3 | NA | OK | NENHUM | ORDEM
3 | SUM | 507 | 507 | 508 | 3041815279 | 51001 | 00 | ACEITO | 0F83 | 0F83 | SIM | 4 | NA | OK | NENHUM | ORDEM
3 | SUM | 508 | 508 | 509 | 3041866278 | 50999 | 00 | ACEITO | 3B82 | 3B82 | SIM | 3 | NA | OK | NENHUM | ORDEM
3 | SUM | 509 | 509 | 510 | 3041917279 | 51001 | 00 | ACEITO | 22C7 | 22C7 | SIM | 4 | NA | OK | NENHUM | ORDEM
3 | SUM | 510 | 510 | 511 | 3041968278 | 50999 | 00 | ACEITO | 181C | 181C | SIM | 3 | NA | OK | NENHUM | ORDEM
3 | SUM | 511 | 511 | 512 | 3042019279 | 51001 | 00 | ACEITO | 1206 | 1206 | SIM | 4 | NA | OK | NENHUM | ORDEM
3 | SUM | 512 | 512 | 513 | 3042070278 | 50999 | 00 | ACEITO | D163 | D163 | SIM | 3 | NA | OK | NENHUM | ORDEM
3 | SUM | 513 | 513 | 514 | 3042121280 | 51002 | 00 | ACEITO | 2C42 | 2C42 | SIM | 4 | NA | OK | NENHUM | ORDEM
3 | SUM | 514 | 514 | 515 | 3042172279 | 50999 | 00 | ACEITO | 0C12 | 0C12 | SIM | 3 | NA | OK | NENHUM | ORDEM
3 | SUM | 515 | 515 | 516 | 3042223280 | 51001 | 00 | ACEITO | 2972 | 2972 | SIM | 4 | NA | OK | NENHUM | ORDEM
3 | SUM | 516 | 516 | 517 | 3042274279 | 50999 | 00 | ACEITO | 53A5 | 53A5 | SIM | 3 | NA | OK | NENHUM | ORDEM
3 | SUM | 517 | 517 | 518 | 3042325280 | 51001 | 00 | ACEITO | E4C7 | E4C7 | SIM | 4 | NA | OK | NENHUM | ORDEM
3 | SUM | 518 | 518 | 519 | 3042376279 | 50999 | 00 | ACEITO | 8549 | 8549 | SIM | 3 | NA | OK | NENHUM | ORDEM
3 | SUM | 519 | 519 | 520 | 3042427280 | 51001 | 00 | ACEITO | 7803 | 7803 | SIM | 4 | NA | OK | NENHUM | ORDEM
3 | SUM | 520 | 520 | 521 | 3042478279 | 50999 | 00 | ACEITO | 490E | 490E | SIM | 3 | NA | OK | NENHUM | ORDEM
3 | SUM | 521 | 521 | 522 | 3042529280 | 51001 | 00 | ACEITO | DAE7 | DAE7 | SIM | 4 | NA | OK | NENHUM | ORDEM
3 | SUM | 522 | 522 | 523 | 3042580279 | 50999 | 00 | ACEITO | 7DD8 | 7DD8 | SIM | 3 | NA | OK | NENHUM | ORDEM
3 | SUM | 523 | 523 | 524 | 3042631280 | 51001 | 00 | ACEITO | A825 | A825 | SIM | 4 | NA | OK | NENHUM | ORDEM
3 | SUM | 524 | 524 | 525 | 3042682279 | 50999 | 00 | ACEITO | 5B1E | 5B1E | SIM | 3 | NA | OK | NENHUM | ORDEM
3 | SUM | 525 | 525 | 526 | 3042733280 | 51001 | 00 | ACEITO | 3717 | 3717 | SIM | 4 | NA | OK | NENHUM | ORDEM
3 | SUM | 526 | 526 | 527 | 3042784279 | 50999 | 00 | ACEITO | 70D3 | 70D3 | SIM | 3 | NA | OK | NENHUM | ORDEM
3 | SUM | 527 | 527 | 528 | 3042835280 | 51001 | 00 | ACEITO | D971 | D971 | SIM | 3 | NA | OK | NENHUM | ORDEM
3 | SUM | 528 | 528 | 529 | 3042886279 | 50999 | 00 | ACEITO | B08F | B08F | SIM | 3 | NA | OK | NENHUM | ORDEM
3 | SUM | 529 | 529 | 530 | 3042937280 | 51001 | 00 | ACEITO | 30C5 | 30C5 | SIM | 3 | NA | OK | NENHUM | ORDEM
3 | SUM | 530 | 530 | 531 | 3042988279 | 50999 | 00 | ACEITO | 8CC8 | 8CC8 | SIM | 3 | NA | OK | NENHUM | ORDEM
3 | SUM | 531 | 531 | 532 | 3043039280 | 51001 | 00 | ACEITO | 4A17 | 4A17 | SIM | 3 | NA | OK | NENHUM | ORDEM
3 | SUM | 532 | 532 | 533 | 3043090279 | 50999 | 00 | ACEITO | 3558 | 3558 | SIM | 3 | NA | OK | NENHUM | ORDEM
3 | SUM | 533 | 533 | 534 | 3043141280 | 51001 | 00 | ACEITO | 1326 | 1326 | SIM | 3 | NA | OK | NENHUM | ORDEM
3 | SUM | 534 | 534 | 535 | 3043192279 | 50999 | 00 | ACEITO | E3C6 | E3C6 | SIM | 3 | NA | OK | NENHUM | ORDEM
3 | SUM | 535 | 535 | 536 | 3043243280 | 51001 | 00 | ACEITO | 38CC | 38CC | SIM | 3 | NA | OK | NENHUM | ORDEM
3 | SUM | 536 | 536 | 537 | 3043294279 | 50999 | 00 | ACEITO | 6926 | 6926 | SIM | 3 | NA | OK | NENHUM | ORDEM
3 | SUM | 537 | 537 | 538 | 3043345280 | 51001 | 00 | ACEITO | 751A | 751A | SIM | 3 | NA | OK | NENHUM | ORDEM
3 | SUM | 538 | 538 | 539 | 3043396279 | 50999 | 00 | ACEITO | 947C | 947C | SIM | 3 | NA | OK | NENHUM | ORDEM
3 | SUM | 539 | 539 | 540 | 3043447280 | 51001 | 00 | ACEITO | A27F | A27F | SIM | 3 | NA | OK | NENHUM | ORDEM
3 | SUM | 540 | 540 | 541 | 3043498279 | 50999 | 00 | ACEITO | 1855 | 1855 | SIM | 3 | NA | OK | NENHUM | ORDEM
3 | SUM | 541 | 541 | 542 | 3043549280 | 51001 | 00 | ACEITO | D8E7 | D8E7 | SIM | 3 | NA | OK | NENHUM | ORDEM
3 | SUM | 542 | 542 | 543 | 3043600279 | 50999 | 00 | ACEITO | C057 | C057 | SIM | 3 | NA | OK | NENHUM | ORDEM
3 | SUM | 543 | 543 | 544 | 3043651280 | 51001 | 00 | ACEITO | 8BC6 | 8BC6 | SIM | 3 | NA | OK | NENHUM | ORDEM
3 | SUM | 544 | 544 | 545 | 3043702279 | 50999 | 00 | ACEITO | F70B | F70B | SIM | 3 | NA | OK | NENHUM | ORDEM
3 | SUM | 545 | 545 | 546 | 3043753280 | 51001 | 00 | ACEITO | 4300 | 4300 | SIM | 3 | NA | OK | NENHUM | ORDEM
3 | SUM | 546 | 546 | 547 | 3043804279 | 50999 | 00 | ACEITO | DA10 | DA10 | SIM | 3 | NA | OK | NENHUM | ORDEM
3 | SUM | 547 | 547 | 548 | 3043855280 | 51001 | 00 | ACEITO | 80D4 | 80D4 | SIM | 3 | NA | OK | NENHUM | ORDEM
3 | SUM | 548 | 548 | 549 | 3043906279 | 50999 | 00 | ACEITO | 0BA5 | 0BA5 | SIM | 3 | NA | OK | NENHUM | ORDEM
3 | SUM | 549 | 549 | 550 | 3043957280 | 51001 | 00 | ACEITO | 1034 | 1034 | SIM | 3 | NA | OK | NENHUM | ORDEM
3 | SUM | 550 | 550 | 551 | 3044008279 | 50999 | 00 | ACEITO | 33AB | 33AB | SIM | 3 | NA | OK | NENHUM | ORDEM
3 | SUM | 551 | 551 | 552 | 3044059280 | 51001 | 00 | ACEITO | 3D11 | 3D11 | SIM | 3 | NA | OK | NENHUM | ORDEM
3 | SUM | 552 | 552 | 553 | 3044110279 | 50999 | 00 | ACEITO | 51B9 | 51B9 | SIM | 3 | NA | OK | NENHUM | ORDEM
3 | SUM | 553 | 553 | 554 | 3044161280 | 51001 | 00 | ACEITO | E852 | E852 | SIM | 3 | NA | OK | NENHUM | ORDEM
3 | SUM | 554 | 554 | 555 | 3044212279 | 50999 | 00 | ACEITO | B220 | B220 | SIM | 4 | NA | OK | NENHUM | ORDEM
3 | SUM | 555 | 555 | 556 | 3044263280 | 51001 | 00 | ACEITO | 30F6 | 30F6 | SIM | 3 | NA | OK | NENHUM | ORDEM
3 | SUM | 556 | 556 | 557 | 3044314279 | 50999 | 00 | ACEITO | D58E | D58E | SIM | 4 | NA | OK | NENHUM | ORDEM
3 | SUM | 557 | 557 | 558 | 3044365280 | 51001 | 00 | ACEITO | 0166 | 0166 | SIM | 3 | NA | OK | NENHUM | ORDEM
3 | SUM | 558 | 558 | 559 | 3044416279 | 50999 | 00 | ACEITO | D8FC | D8FC | SIM | 4 | NA | OK | NENHUM | ORDEM
3 | SUM | 559 | 559 | 560 | 3044467280 | 51001 | 00 | ACEITO | 5EAB | 5EAB | SIM | 3 | NA | OK | NENHUM | ORDEM
3 | SUM | 560 | 560 | 561 | 3044518279 | 50999 | 00 | ACEITO | 6F97 | 6F97 | SIM | 4 | NA | OK | NENHUM | ORDEM
3 | SUM | 561 | 561 | 562 | 3044569280 | 51001 | 00 | ACEITO | 9246 | 9246 | SIM | 3 | NA | OK | NENHUM | ORDEM
3 | SUM | 562 | 562 | 563 | 3044620279 | 50999 | 00 | ACEITO | 6665 | 6665 | SIM | 4 | NA | OK | NENHUM | ORDEM
3 | SUM | 563 | 563 | 564 | 3044671280 | 51001 | 00 | ACEITO | FADA | FADA | SIM | 3 | NA | OK | NENHUM | ORDEM
3 | SUM | 564 | 564 | 565 | 3044722279 | 50999 | 00 | ACEITO | 8462 | 8462 | SIM | 4 | NA | OK | NENHUM | ORDEM
3 | SUM | 565 | 565 | 566 | 3044773280 | 51001 | 00 | ACEITO | FF0E | FF0E | SIM | 3 | NA | OK | NENHUM | ORDEM
3 | SUM | 566 | 566 | 567 | 3044824285 | 51005 | 00 | ACEITO | 6DE8 | 6DE8 | SIM | 4 | NA | OK | NENHUM | ORDEM
3 | SUM | 567 | 567 | 568 | 3044875286 | 51001 | 00 | ACEITO | DA0C | DA0C | SIM | 4 | NA | OK | NENHUM | ORDEM
3 | SUM | 568 | 568 | 569 | 3044926285 | 50999 | 00 | ACEITO | 5AA7 | 5AA7 | SIM | 4 | NA | OK | NENHUM | ORDEM
3 | SUM | 569 | 569 | 570 | 3044977286 | 51001 | 00 | ACEITO | C6A6 | C6A6 | SIM | 4 | NA | OK | NENHUM | ORDEM
3 | SUM | 570 | 570 | 571 | 3045028285 | 50999 | 00 | ACEITO | 3801 | 3801 | SIM | 4 | NA | OK | NENHUM | ORDEM
3 | SUM | 571 | 571 | 572 | 3045079286 | 51001 | 00 | ACEITO | 8D80 | 8D80 | SIM | 4 | NA | OK | NENHUM | ORDEM
3 | SUM | 572 | 572 | 573 | 3045130285 | 50999 | 00 | ACEITO | 2A47 | 2A47 | SIM | 4 | NA | OK | NENHUM | ORDEM
3 | SUM | 573 | 573 | 574 | 3045181286 | 51001 | 00 | ACEITO | 9303 | 9303 | SIM | 4 | NA | OK | NENHUM | ORDEM
3 | SUM | 574 | 574 | 575 | 3045232285 | 50999 | 00 | ACEITO | 1DCE | 1DCE | SIM | 4 | NA | OK | NENHUM | ORDEM
3 | SUM | 575 | 575 | 576 | 3045283286 | 51001 | 00 | ACEITO | F6DD | F6DD | SIM | 4 | NA | OK | NENHUM | ORDEM
3 | SUM | 576 | 576 | 577 | 3045334285 | 50999 | 00 | ACEITO | DF30 | DF30 | SIM | 4 | NA | OK | NENHUM | ORDEM
3 | SUM | 577 | 577 | 578 | 3045385286 | 51001 | 00 | ACEITO | 7736 | 7736 | SIM | 4 | NA | OK | NENHUM | ORDEM
3 | SUM | 578 | 578 | 579 | 3045436285 | 50999 | 00 | ACEITO | 70DC | 70DC | SIM | 4 | NA | OK | NENHUM | ORDEM
3 | SUM | 579 | 579 | 580 | 3045487286 | 51001 | 00 | ACEITO | DF04 | DF04 | SIM | 4 | NA | OK | NENHUM | ORDEM
3 | SUM | 580 | 580 | 581 | 3045538285 | 50999 | 00 | ACEITO | F0B7 | F0B7 | SIM | 4 | NA | OK | NENHUM | ORDEM
3 | SUM | 581 | 581 | 582 | 3045589286 | 51001 | 00 | ACEITO | 9562 | 9562 | SIM | 4 | NA | OK | NENHUM | ORDEM
3 | SUM | 582 | 582 | 583 | 3045640285 | 50999 | 00 | ACEITO | 306E | 306E | SIM | 4 | NA | OK | NENHUM | ORDEM
3 | SUM | 583 | 583 | 584 | 3045691286 | 51001 | 00 | ACEITO | C2C1 | C2C1 | SIM | 4 | NA | OK | NENHUM | ORDEM
3 | SUM | 584 | 584 | 585 | 3045742285 | 50999 | 00 | ACEITO | 6684 | 6684 | SIM | 4 | NA | OK | NENHUM | ORDEM
3 | SUM | 585 | 585 | 586 | 3045793286 | 51001 | 00 | ACEITO | 413C | 413C | SIM | 4 | NA | OK | NENHUM | ORDEM
3 | SUM | 586 | 586 | 587 | 3045844285 | 50999 | 00 | ACEITO | 64BB | 64BB | SIM | 4 | NA | OK | NENHUM | ORDEM
3 | SUM | 587 | 587 | 588 | 3045895286 | 51001 | 00 | ACEITO | 5512 | 5512 | SIM | 4 | NA | OK | NENHUM | ORDEM
3 | SUM | 588 | 588 | 589 | 3045946285 | 50999 | 00 | ACEITO | 2972 | 2972 | SIM | 4 | NA | OK | NENHUM | ORDEM
3 | SUM | 589 | 589 | 590 | 3045997286 | 51001 | 00 | ACEITO | 025A | 025A | SIM | 4 | NA | OK | NENHUM | ORDEM
3 | SUM | 590 | 590 | 591 | 3046048285 | 50999 | 00 | ACEITO | CED5 | CED5 | SIM | 4 | NA | OK | NENHUM | ORDEM
3 | SUM | 591 | 591 | 592 | 3046099286 | 51001 | 00 | ACEITO | 82A6 | 82A6 | SIM | 4 | NA | OK | NENHUM | ORDEM
3 | SUM | 592 | 592 | 593 | 3046150285 | 50999 | 00 | ACEITO | 92F1 | 92F1 | SIM | 3 | NA | OK | NENHUM | ORDEM
3 | SUM | 593 | 593 | 594 | 3046201286 | 51001 | 00 | ACEITO | A3C5 | A3C5 | SIM | 4 | NA | OK | NENHUM | ORDEM
3 | SUM | 594 | 594 | 595 | 3046252285 | 50999 | 00 | ACEITO | 513A | 513A | SIM | 3 | NA | OK | NENHUM | ORDEM
3 | SUM | 595 | 595 | 596 | 3046303286 | 51001 | 00 | ACEITO | E02F | E02F | SIM | 4 | NA | OK | NENHUM | ORDEM
3 | SUM | 596 | 596 | 597 | 3046354285 | 50999 | 00 | ACEITO | C0CD | C0CD | SIM | 3 | NA | OK | NENHUM | ORDEM
3 | SUM | 597 | 597 | 598 | 3046405286 | 51001 | 00 | ACEITO | F15F | F15F | SIM | 4 | NA | OK | NENHUM | ORDEM
3 | SUM | 598 | 598 | 599 | 3046456285 | 50999 | 00 | ACEITO | 0077 | 0077 | SIM | 3 | NA | OK | NENHUM | ORDEM
3 | SUM | 599 | 599 | 600 | 3046507286 | 51001 | 00 | ACEITO | 0C50 | 0C50 | SIM | 4 | NA | OK | NENHUM | ORDEM
3 | SUM | 600 | 600 | 601 | 3046558285 | 50999 | 00 | ACEITO | 994D | 994D | SIM | 3 | NA | OK | NENHUM | ORDEM
3 | SUM | 601 | 601 | 602 | 3046609286 | 51001 | 00 | ACEITO | 30B6 | 30B6 | SIM | 4 | NA | OK | NENHUM | ORDEM
3 | SUM | 602 | 602 | 603 | 3046660285 | 50999 | 00 | ACEITO | 2DC4 | 2DC4 | SIM | 3 | NA | OK | NENHUM | ORDEM
3 | SUM | 603 | 603 | 604 | 3046711286 | 51001 | 00 | ACEITO | DA2C | DA2C | SIM | 4 | NA | OK | NENHUM | ORDEM
3 | SUM | 604 | 604 | 605 | 3046762285 | 50999 | 00 | ACEITO | 814D | 814D | SIM | 3 | NA | OK | NENHUM | ORDEM
3 | SUM | 605 | 605 | 606 | 3046813286 | 51001 | 00 | ACEITO | 2C74 | 2C74 | SIM | 3 | NA | OK | NENHUM | ORDEM
3 | SUM | 606 | 606 | 607 | 3046864285 | 50999 | 00 | ACEITO | 0617 | 0617 | SIM | 4 | NA | OK | NENHUM | ORDEM
3 | SUM | 607 | 607 | 608 | 3046915286 | 51001 | 00 | ACEITO | 8958 | 8958 | SIM | 3 | NA | OK | NENHUM | ORDEM
3 | SUM | 608 | 608 | 609 | 3046966285 | 50999 | 00 | ACEITO | C153 | C153 | SIM | 3 | NA | OK | NENHUM | ORDEM
3 | SUM | 609 | 609 | 610 | 3047017286 | 51001 | 00 | ACEITO | 41EB | 41EB | SIM | 3 | NA | OK | NENHUM | ORDEM
3 | SUM | 610 | 610 | 611 | 3047068285 | 50999 | 00 | ACEITO | AFE4 | AFE4 | SIM | 4 | NA | OK | NENHUM | ORDEM
3 | SUM | 611 | 611 | 612 | 3047119286 | 51001 | 00 | ACEITO | E14D | E14D | SIM | 3 | NA | OK | NENHUM | ORDEM
3 | SUM | 612 | 612 | 613 | 3047170285 | 50999 | 00 | ACEITO | 73C0 | 73C0 | SIM | 3 | NA | OK | NENHUM | ORDEM
3 | SUM | 613 | 613 | 614 | 3047221286 | 51001 | 00 | ACEITO | A65F | A65F | SIM | 3 | NA | OK | NENHUM | ORDEM
3 | SUM | 614 | 614 | 615 | 3047272285 | 50999 | 00 | ACEITO | F86B | F86B | SIM | 4 | NA | OK | NENHUM | ORDEM
3 | SUM | 615 | 615 | 616 | 3047323286 | 51001 | 00 | ACEITO | 7C1C | 7C1C | SIM | 3 | NA | OK | NENHUM | ORDEM
3 | SUM | 616 | 616 | 617 | 3047374285 | 50999 | 00 | ACEITO | 6DD4 | 6DD4 | SIM | 3 | NA | OK | NENHUM | ORDEM
3 | SUM | 617 | 617 | 618 | 3047425286 | 51001 | 00 | ACEITO | 5B7B | 5B7B | SIM | 3 | NA | OK | NENHUM | ORDEM
3 | SUM | 618 | 618 | 619 | 3047476285 | 50999 | 00 | ACEITO | 47C4 | 47C4 | SIM | 3 | NA | OK | NENHUM | ORDEM
3 | SUM | 619 | 619 | 620 | 3047527286 | 51001 | 00 | ACEITO | C84D | C84D | SIM | 3 | NA | OK | NENHUM | ORDEM
3 | SUM | 620 | 620 | 621 | 3047578285 | 50999 | 00 | ACEITO | 5D7C | 5D7C | SIM | 3 | NA | OK | NENHUM | ORDEM
3 | SUM | 621 | 621 | 622 | 3047629286 | 51001 | 00 | ACEITO | 1970 | 1970 | SIM | 3 | NA | OK | NENHUM | ORDEM
3 | SUM | 622 | 622 | 623 | 3047680285 | 50999 | 00 | ACEITO | E838 | E838 | SIM | 3 | NA | OK | NENHUM | ORDEM
3 | SUM | 623 | 623 | 624 | 3047731286 | 51001 | 00 | ACEITO | 7D06 | 7D06 | SIM | 3 | NA | OK | NENHUM | ORDEM
3 | SUM | 624 | 624 | 625 | 3047782285 | 50999 | 00 | ACEITO | F7A2 | F7A2 | SIM | 3 | NA | OK | NENHUM | ORDEM
3 | SUM | 625 | 625 | 626 | 3047833286 | 51001 | 00 | ACEITO | A907 | A907 | SIM | 3 | NA | OK | NENHUM | ORDEM
3 | SUM | 626 | 626 | 627 | 3047884285 | 50999 | 00 | ACEITO | 2246 | 2246 | SIM | 3 | NA | OK | NENHUM | ORDEM
3 | SUM | 627 | 627 | 628 | 3047935286 | 51001 | 00 | ACEITO | 83E7 | 83E7 | SIM | 3 | NA | OK | NENHUM | ORDEM
3 | SUM | 628 | 628 | 629 | 3047986285 | 50999 | 00 | ACEITO | 9B53 | 9B53 | SIM | 4 | NA | OK | NENHUM | ORDEM
3 | SUM | 629 | 629 | 630 | 3048037286 | 51001 | 00 | ACEITO | 4AF5 | 4AF5 | SIM | 3 | NA | OK | NENHUM | ORDEM
3 | SUM | 630 | 630 | 631 | 3048088285 | 50999 | 00 | ACEITO | 18C7 | 18C7 | SIM | 3 | NA | OK | NENHUM | ORDEM
3 | SUM | 631 | 631 | 632 | 3048139286 | 51001 | 00 | ACEITO | 5B19 | 5B19 | SIM | 3 | NA | OK | NENHUM | ORDEM
3 | SUM | 632 | 632 | 633 | 3048190285 | 50999 | 00 | ACEITO | CA38 | CA38 | SIM | 4 | NA | OK | NENHUM | ORDEM
3 | SUM | 633 | 633 | 634 | 3048241286 | 51001 | 00 | ACEITO | 247F | 247F | SIM | 3 | NA | OK | NENHUM | ORDEM
3 | SUM | 634 | 634 | 635 | 3048292285 | 50999 | 00 | ACEITO | 220A | 220A | SIM | 4 | NA | OK | NENHUM | ORDEM
3 | SUM | 635 | 635 | 636 | 3048343286 | 51001 | 00 | ACEITO | D228 | D228 | SIM | 3 | NA | OK | NENHUM | ORDEM
3 | SUM | 636 | 636 | 637 | 3048394285 | 50999 | 00 | ACEITO | D594 | D594 | SIM | 4 | NA | OK | NENHUM | ORDEM
3 | SUM | 637 | 637 | 638 | 3048445286 | 51001 | 00 | ACEITO | 49BE | 49BE | SIM | 3 | NA | OK | NENHUM | ORDEM
3 | SUM | 638 | 638 | 639 | 3048496285 | 50999 | 00 | ACEITO | CFC5 | CFC5 | SIM | 4 | NA | OK | NENHUM | ORDEM
3 | SUM | 639 | 639 | 640 | 3048547286 | 51001 | 00 | ACEITO | D7CC | D7CC | SIM | 3 | NA | OK | NENHUM | ORDEM
3 | SUM | 640 | 640 | 641 | 3048598285 | 50999 | 00 | ACEITO | 2E7D | 2E7D | SIM | 4 | NA | OK | NENHUM | ORDEM
3 | SUM | 641 | 641 | 642 | 3048649286 | 51001 | 00 | ACEITO | 9857 | 9857 | SIM | 3 | NA | OK | NENHUM | ORDEM
3 | SUM | 642 | 642 | 643 | 3048700285 | 50999 | 00 | ACEITO | 4547 | 4547 | SIM | 4 | NA | OK | NENHUM | ORDEM
3 | SUM | 643 | 643 | 644 | 3048751286 | 51001 | 00 | ACEITO | 344B | 344B | SIM | 3 | NA | OK | NENHUM | ORDEM
3 | SUM | 644 | 644 | 645 | 3048802285 | 50999 | 00 | ACEITO | 6BB9 | 6BB9 | SIM | 4 | NA | OK | NENHUM | ORDEM
3 | SUM | 645 | 645 | 646 | 3048853287 | 51002 | 00 | ACEITO | 110D | 110D | SIM | 3 | NA | OK | NENHUM | ORDEM
3 | SUM | 646 | 646 | 647 | 3048904285 | 50998 | 00 | ACEITO | 4CCB | 4CCB | SIM | 4 | NA | OK | NENHUM | ORDEM
3 | SUM | 647 | 647 | 648 | 3048955287 | 51002 | 00 | ACEITO | 0B0D | 0B0D | SIM | 3 | NA | OK | NENHUM | ORDEM
3 | SUM | 648 | 648 | 649 | 3049006285 | 50998 | 00 | ACEITO | 2742 | 2742 | SIM | 4 | NA | OK | NENHUM | ORDEM
3 | SUM | 649 | 649 | 650 | 3049057287 | 51002 | 00 | ACEITO | 36D7 | 36D7 | SIM | 3 | NA | OK | NENHUM | ORDEM
3 | SUM | 650 | 650 | 651 | 3049108285 | 50998 | 00 | ACEITO | 8BCD | 8BCD | SIM | 4 | NA | OK | NENHUM | ORDEM
3 | SUM | 651 | 651 | 652 | 3049159287 | 51002 | 00 | ACEITO | 5632 | 5632 | SIM | 3 | NA | OK | NENHUM | ORDEM
3 | SUM | 652 | 652 | 653 | 3049210285 | 50998 | 00 | ACEITO | 2270 | 2270 | SIM | 4 | NA | OK | NENHUM | ORDEM
3 | SUM | 653 | 653 | 654 | 3049261287 | 51002 | 00 | ACEITO | 6E88 | 6E88 | SIM | 3 | NA | OK | NENHUM | ORDEM
3 | SUM | 654 | 654 | 655 | 3049312285 | 50998 | 00 | ACEITO | A4B2 | A4B2 | SIM | 4 | NA | OK | NENHUM | ORDEM
3 | SUM | 655 | 655 | 656 | 3049363287 | 51002 | 00 | ACEITO | D72F | D72F | SIM | 3 | NA | OK | NENHUM | ORDEM
3 | SUM | 656 | 656 | 657 | 3049414285 | 50998 | 00 | ACEITO | 40FC | 40FC | SIM | 4 | NA | OK | NENHUM | ORDEM
3 | SUM | 657 | 657 | 658 | 3049465287 | 51002 | 00 | ACEITO | 6ED6 | 6ED6 | SIM | 4 | NA | OK | NENHUM | ORDEM
3 | SUM | 658 | 658 | 659 | 3049516285 | 50998 | 00 | ACEITO | 8545 | 8545 | SIM | 4 | NA | OK | NENHUM | ORDEM
3 | SUM | 659 | 659 | 660 | 3049567287 | 51002 | 00 | ACEITO | B52C | B52C | SIM | 4 | NA | OK | NENHUM | ORDEM
3 | SUM | 660 | 660 | 661 | 3049618285 | 50998 | 00 | ACEITO | C6B5 | C6B5 | SIM | 4 | NA | OK | NENHUM | ORDEM
3 | SUM | 661 | 661 | 662 | 3049669287 | 51002 | 00 | ACEITO | D574 | D574 | SIM | 4 | NA | OK | NENHUM | ORDEM
3 | SUM | 662 | 662 | 663 | 3049720285 | 50998 | 00 | ACEITO | A74C | A74C | SIM | 4 | NA | OK | NENHUM | ORDEM
3 | SUM | 663 | 663 | 664 | 3049771287 | 51002 | 00 | ACEITO | 8F06 | 8F06 | SIM | 4 | NA | OK | NENHUM | ORDEM
3 | SUM | 664 | 664 | 665 | 3049822285 | 50998 | 00 | ACEITO | 7DBC | 7DBC | SIM | 4 | NA | OK | NENHUM | ORDEM
3 | SUM | 665 | 665 | 666 | 3049873287 | 51002 | 00 | ACEITO | AF0E | AF0E | SIM | 4 | NA | OK | NENHUM | ORDEM
3 | SUM | 666 | 666 | 667 | 3049924285 | 50998 | 00 | ACEITO | 40FE | 40FE | SIM | 4 | NA | OK | NENHUM | ORDEM
3 | SUM | 667 | 667 | 668 | 3049975287 | 51002 | 00 | ACEITO | E345 | E345 | SIM | 4 | NA | OK | NENHUM | ORDEM
3 | SUM | 668 | 668 | 669 | 3050026285 | 50998 | 00 | ACEITO | 6F1E | 6F1E | SIM | 4 | NA | OK | NENHUM | ORDEM
3 | SUM | 669 | 669 | 670 | 3050077287 | 51002 | 00 | ACEITO | 9D8E | 9D8E | SIM | 4 | NA | OK | NENHUM | ORDEM
3 | SUM | 670 | 670 | 671 | 3050128285 | 50998 | 00 | ACEITO | 2AE5 | 2AE5 | SIM | 4 | NA | OK | NENHUM | ORDEM
3 | SUM | 671 | 671 | 672 | 3050179287 | 51002 | 00 | ACEITO | F34F | F34F | SIM | 4 | NA | OK | NENHUM | ORDEM
3 | SUM | 672 | 672 | 673 | 3050230285 | 50998 | 00 | ACEITO | 6A82 | 6A82 | SIM | 4 | NA | OK | NENHUM | ORDEM
3 | SUM | 673 | 673 | 674 | 3050281286 | 51001 | 00 | ACEITO | 0BA0 | 0BA0 | SIM | 4 | NA | OK | NENHUM | ORDEM
3 | SUM | 674 | 674 | 675 | 3050332285 | 50999 | 00 | ACEITO | 94BA | 94BA | SIM | 4 | NA | OK | NENHUM | ORDEM
3 | SUM | 675 | 675 | 676 | 3050383286 | 51001 | 00 | ACEITO | 8D48 | 8D48 | SIM | 4 | NA | OK | NENHUM | ORDEM
3 | SUM | 676 | 676 | 677 | 3050434285 | 50999 | 00 | ACEITO | 9119 | 9119 | SIM | 4 | NA | OK | NENHUM | ORDEM
3 | SUM | 677 | 677 | 678 | 3050485286 | 51001 | 00 | ACEITO | 2A12 | 2A12 | SIM | 4 | NA | OK | NENHUM | ORDEM
3 | SUM | 678 | 678 | 679 | 3050536285 | 50999 | 00 | ACEITO | 545A | 545A | SIM | 4 | NA | OK | NENHUM | ORDEM
3 | SUM | 679 | 679 | 680 | 3050587286 | 51001 | 00 | ACEITO | 4956 | 4956 | SIM | 4 | NA | OK | NENHUM | ORDEM
3 | SUM | 680 | 680 | 681 | 3050638285 | 50999 | 00 | ACEITO | 3B49 | 3B49 | SIM | 4 | NA | OK | NENHUM | ORDEM
3 | SUM | 681 | 681 | 682 | 3050689286 | 51001 | 00 | ACEITO | EDC9 | EDC9 | SIM | 4 | NA | OK | NENHUM | ORDEM
3 | SUM | 682 | 682 | 683 | 3050740285 | 50999 | 00 | ACEITO | 64D0 | 64D0 | SIM | 4 | NA | OK | NENHUM | ORDEM
3 | SUM | 683 | 683 | 684 | 3050791286 | 51001 | 00 | ACEITO | 5019 | 5019 | SIM | 4 | NA | OK | NENHUM | ORDEM
3 | SUM | 684 | 684 | 685 | 3050842285 | 50999 | 00 | ACEITO | F4FC | F4FC | SIM | 4 | NA | OK | NENHUM | ORDEM
3 | SUM | 685 | 685 | 686 | 3050893286 | 51001 | 00 | ACEITO | DC81 | DC81 | SIM | 4 | NA | OK | NENHUM | ORDEM
3 | SUM | 686 | 686 | 687 | 3050944285 | 50999 | 00 | ACEITO | 940E | 940E | SIM | 4 | NA | OK | NENHUM | ORDEM
3 | SUM | 687 | 687 | 688 | 3050995286 | 51001 | 00 | ACEITO | 2145 | 2145 | SIM | 4 | NA | OK | NENHUM | ORDEM
3 | SUM | 688 | 688 | 689 | 3051046285 | 50999 | 00 | ACEITO | 384D | 384D | SIM | 4 | NA | OK | NENHUM | ORDEM
3 | SUM | 689 | 689 | 690 | 3051097286 | 51001 | 00 | ACEITO | CE40 | CE40 | SIM | 4 | NA | OK | NENHUM | ORDEM
3 | SUM | 690 | 690 | 691 | 3051148285 | 50999 | 00 | ACEITO | 51D1 | 51D1 | SIM | 4 | NA | OK | NENHUM | ORDEM
3 | SUM | 691 | 691 | 692 | 3051199286 | 51001 | 00 | ACEITO | 7768 | 7768 | SIM | 4 | NA | OK | NENHUM | ORDEM
3 | SUM | 692 | 692 | 693 | 3051250285 | 50999 | 00 | ACEITO | E3A9 | E3A9 | SIM | 4 | NA | OK | NENHUM | ORDEM
3 | SUM | 693 | 693 | 694 | 3051301286 | 51001 | 00 | ACEITO | AFD9 | AFD9 | SIM | 4 | NA | OK | NENHUM | ORDEM
3 | SUM | 694 | 694 | 695 | 3051352285 | 50999 | 00 | ACEITO | 2B09 | 2B09 | SIM | 4 | NA | OK | NENHUM | ORDEM
3 | SUM | 695 | 695 | 696 | 3051403286 | 51001 | 00 | ACEITO | 10F7 | 10F7 | SIM | 4 | NA | OK | NENHUM | ORDEM
3 | SUM | 696 | 696 | 697 | 3051454285 | 50999 | 00 | ACEITO | B088 | B088 | SIM | 4 | NA | OK | NENHUM | ORDEM
3 | SUM | 697 | 697 | 698 | 3051505286 | 51001 | 00 | ACEITO | 325E | 325E | SIM | 4 | NA | OK | NENHUM | ORDEM
3 | SUM | 698 | 698 | 699 | 3051556285 | 50999 | 00 | ACEITO | BC9B | BC9B | SIM | 4 | NA | OK | NENHUM | ORDEM
3 | SUM | 699 | 699 | 700 | 3051607286 | 51001 | 00 | ACEITO | 559E | 559E | SIM | 4 | NA | OK | NENHUM | ORDEM
3 | SUM | 700 | 700 | 701 | 3051658285 | 50999 | 00 | ACEITO | 7AB8 | 7AB8 | SIM | 4 | NA | OK | NENHUM | ORDEM
3 | SUM | 701 | 701 | 702 | 3051709286 | 51001 | 00 | ACEITO | F2EE | F2EE | SIM | 4 | NA | OK | NENHUM | ORDEM
3 | SUM | 702 | 702 | 703 | 3051760285 | 50999 | 00 | ACEITO | 2B26 | 2B26 | SIM | 4 | NA | OK | NENHUM | ORDEM
3 | SUM | 703 | 703 | 704 | 3051811286 | 51001 | 00 | ACEITO | 9986 | 9986 | SIM | 4 | NA | OK | NENHUM | ORDEM
3 | SUM | 704 | 704 | 705 | 3051862285 | 50999 | 00 | ACEITO | C2D3 | C2D3 | SIM | 4 | NA | OK | NENHUM | ORDEM
3 | SUM | 705 | 705 | 706 | 3051913286 | 51001 | 00 | ACEITO | 7EEE | 7EEE | SIM | 4 | NA | OK | NENHUM | ORDEM
3 | SUM | 706 | 706 | 707 | 3051964285 | 50999 | 00 | ACEITO | 0901 | 0901 | SIM | 4 | NA | OK | NENHUM | ORDEM
3 | SUM | 707 | 707 | 708 | 3052015286 | 51001 | 00 | ACEITO | CCEA | CCEA | SIM | 4 | NA | OK | NENHUM | ORDEM
3 | SUM | 708 | 708 | 709 | 3052066285 | 50999 | 00 | ACEITO | 1900 | 1900 | SIM | 4 | NA | OK | NENHUM | ORDEM
3 | SUM | 709 | 709 | 710 | 3052117286 | 51001 | 00 | ACEITO | 7F77 | 7F77 | SIM | 4 | NA | OK | NENHUM | ORDEM
3 | SUM | 710 | 710 | 711 | 3052168285 | 50999 | 00 | ACEITO | B6B7 | B6B7 | SIM | 4 | NA | OK | NENHUM | ORDEM
3 | SUM | 711 | 711 | 712 | 3052219286 | 51001 | 00 | ACEITO | 3821 | 3821 | SIM | 4 | NA | OK | NENHUM | ORDEM
3 | SUM | 712 | 712 | 713 | 3052270285 | 50999 | 00 | ACEITO | 09F4 | 09F4 | SIM | 4 | NA | OK | NENHUM | ORDEM
3 | SUM | 713 | 713 | 714 | 3052321286 | 51001 | 00 | ACEITO | 7757 | 7757 | SIM | 4 | NA | OK | NENHUM | ORDEM
3 | SUM | 714 | 714 | 715 | 3052372285 | 50999 | 00 | ACEITO | C64B | C64B | SIM | 4 | NA | OK | NENHUM | ORDEM
3 | SUM | 715 | 715 | 716 | 3052423286 | 51001 | 00 | ACEITO | 0B10 | 0B10 | SIM | 4 | NA | OK | NENHUM | ORDEM
3 | SUM | 716 | 716 | 717 | 3052474285 | 50999 | 00 | ACEITO | 1F82 | 1F82 | SIM | 4 | NA | OK | NENHUM | ORDEM
3 | SUM | 717 | 717 | 718 | 3052525286 | 51001 | 00 | ACEITO | A85A | A85A | SIM | 4 | NA | OK | NENHUM | ORDEM
3 | SUM | 718 | 718 | 719 | 3052576285 | 50999 | 00 | ACEITO | 0F56 | 0F56 | SIM | 4 | NA | OK | NENHUM | ORDEM
3 | SUM | 719 | 719 | 720 | 3052627286 | 51001 | 00 | ACEITO | 870A | 870A | SIM | 4 | NA | OK | NENHUM | ORDEM
3 | SUM | 720 | 720 | 721 | 3052678285 | 50999 | 00 | ACEITO | 4EC8 | 4EC8 | SIM | 4 | NA | OK | NENHUM | ORDEM
3 | SUM | 721 | 721 | 722 | 3052729286 | 51001 | 00 | ACEITO | 2C52 | 2C52 | SIM | 4 | NA | OK | NENHUM | ORDEM
3 | SUM | 722 | 722 | 723 | 3052780285 | 50999 | 00 | ACEITO | 2CF1 | 2CF1 | SIM | 4 | NA | OK | NENHUM | ORDEM
3 | SUM | 723 | 723 | 724 | 3052831285 | 51000 | 00 | ACEITO | A974 | A974 | SIM | 4 | NA | OK | NENHUM | ORDEM
3 | SUM | 724 | 724 | 725 | 3052882285 | 51000 | 00 | ACEITO | E775 | E775 | SIM | 4 | NA | OK | NENHUM | ORDEM
3 | SUM | 725 | 725 | 726 | 3052933285 | 51000 | 00 | ACEITO | 32F5 | 32F5 | SIM | 4 | NA | OK | NENHUM | ORDEM
3 | SUM | 726 | 726 | 727 | 3052984285 | 51000 | 00 | ACEITO | 2599 | 2599 | SIM | 4 | NA | OK | NENHUM | ORDEM
3 | SUM | 727 | 727 | 728 | 3053035285 | 51000 | 00 | ACEITO | 4570 | 4570 | SIM | 4 | NA | OK | NENHUM | ORDEM
3 | SUM | 728 | 728 | 729 | 3053086285 | 51000 | 00 | ACEITO | 6602 | 6602 | SIM | 4 | NA | OK | NENHUM | ORDEM
3 | SUM | 729 | 729 | 730 | 3053137285 | 51000 | 00 | ACEITO | E6D9 | E6D9 | SIM | 4 | NA | OK | NENHUM | ORDEM
3 | SUM | 730 | 730 | 731 | 3053188285 | 51000 | 00 | ACEITO | F895 | F895 | SIM | 4 | NA | OK | NENHUM | ORDEM
3 | SUM | 731 | 731 | 732 | 3053239285 | 51000 | 00 | ACEITO | F220 | F220 | SIM | 4 | NA | OK | NENHUM | ORDEM
3 | SUM | 732 | 732 | 733 | 3053290285 | 51000 | 00 | ACEITO | 8309 | 8309 | SIM | 4 | NA | OK | NENHUM | ORDEM
3 | SUM | 733 | 733 | 734 | 3053341285 | 51000 | 00 | ACEITO | 5A16 | 5A16 | SIM | 4 | NA | OK | NENHUM | ORDEM
3 | SUM | 734 | 734 | 735 | 3053392285 | 51000 | 00 | ACEITO | DDCA | DDCA | SIM | 4 | NA | OK | NENHUM | ORDEM
3 | SUM | 735 | 735 | 736 | 3053443285 | 51000 | 00 | ACEITO | 4863 | 4863 | SIM | 4 | NA | OK | NENHUM | ORDEM
3 | SUM | 736 | 736 | 737 | 3053494285 | 51000 | 00 | ACEITO | F738 | F738 | SIM | 4 | NA | OK | NENHUM | ORDEM
3 | SUM | 737 | 737 | 738 | 3053545285 | 51000 | 00 | ACEITO | 3CDA | 3CDA | SIM | 4 | NA | OK | NENHUM | ORDEM
3 | SUM | 738 | 738 | 739 | 3053596285 | 51000 | 00 | ACEITO | 7562 | 7562 | SIM | 4 | NA | OK | NENHUM | ORDEM
3 | SUM | 739 | 739 | 740 | 3053647285 | 51000 | 00 | ACEITO | 77F7 | 77F7 | SIM | 4 | NA | OK | NENHUM | ORDEM
3 | SUM | 740 | 740 | 741 | 3053698285 | 51000 | 00 | ACEITO | 2053 | 2053 | SIM | 4 | NA | OK | NENHUM | ORDEM
3 | SUM | 741 | 741 | 742 | 3053749285 | 51000 | 00 | ACEITO | 2D97 | 2D97 | SIM | 4 | NA | OK | NENHUM | ORDEM
3 | SUM | 742 | 742 | 743 | 3053800285 | 51000 | 00 | ACEITO | 34A1 | 34A1 | SIM | 4 | NA | OK | NENHUM | ORDEM
3 | SUM | 743 | 743 | 744 | 3053851285 | 51000 | 00 | ACEITO | C0B8 | C0B8 | SIM | 4 | NA | OK | NENHUM | ORDEM
3 | SUM | 744 | 744 | 745 | 3053902285 | 51000 | 00 | ACEITO | 7F6A | 7F6A | SIM | 4 | NA | OK | NENHUM | ORDEM
3 | SUM | 745 | 745 | 746 | 3053953285 | 51000 | 00 | ACEITO | F1BE | F1BE | SIM | 4 | NA | OK | NENHUM | ORDEM
3 | SUM | 746 | 746 | 747 | 3054004285 | 51000 | 00 | ACEITO | 1FBA | 1FBA | SIM | 4 | NA | OK | NENHUM | ORDEM
3 | SUM | 747 | 747 | 748 | 3054055285 | 51000 | 00 | ACEITO | 65F5 | 65F5 | SIM | 4 | NA | OK | NENHUM | ORDEM
3 | SUM | 748 | 748 | 749 | 3054106285 | 51000 | 00 | ACEITO | 0F6E | 0F6E | SIM | 4 | NA | OK | NENHUM | ORDEM
3 | SUM | 749 | 749 | 750 | 3054157285 | 51000 | 00 | ACEITO | 7EB7 | 7EB7 | SIM | 4 | NA | OK | NENHUM | ORDEM
3 | SUM | 750 | 750 | 751 | 3054208285 | 51000 | 00 | ACEITO | F558 | F558 | SIM | 4 | NA | OK | NENHUM | ORDEM
3 | SUM | 751 | 751 | 752 | 3054259285 | 51000 | 00 | ACEITO | BD05 | BD05 | SIM | 4 | NA | OK | NENHUM | ORDEM
3 | SUM | 752 | 752 | 753 | 3054310285 | 51000 | 00 | ACEITO | 2BAA | 2BAA | SIM | 4 | NA | OK | NENHUM | ORDEM
3 | SUM | 753 | 753 | 754 | 3054361285 | 51000 | 00 | ACEITO | 151C | 151C | SIM | 4 | NA | OK | NENHUM | ORDEM
3 | SUM | 754 | 754 | 755 | 3054412285 | 51000 | 00 | ACEITO | FD1B | FD1B | SIM | 4 | NA | OK | NENHUM | ORDEM
3 | SUM | 755 | 755 | 756 | 3054463285 | 51000 | 00 | ACEITO | 03AB | 03AB | SIM | 4 | NA | OK | NENHUM | ORDEM
3 | SUM | 756 | 756 | 757 | 3054514285 | 51000 | 00 | ACEITO | 1039 | 1039 | SIM | 4 | NA | OK | NENHUM | ORDEM
3 | SUM | 757 | 757 | 758 | 3054565285 | 51000 | 00 | ACEITO | 2FCC | 2FCC | SIM | 4 | NA | OK | NENHUM | ORDEM
3 | SUM | 758 | 758 | 759 | 3054616285 | 51000 | 00 | ACEITO | D714 | D714 | SIM | 4 | NA | OK | NENHUM | ORDEM
3 | SUM | 759 | 759 | 760 | 3054667285 | 51000 | 00 | ACEITO | 0A9D | 0A9D | SIM | 4 | NA | OK | NENHUM | ORDEM
3 | SUM | 760 | 760 | 761 | 3054718285 | 51000 | 00 | ACEITO | 8923 | 8923 | SIM | 4 | NA | OK | NENHUM | ORDEM
3 | SUM | 761 | 761 | 762 | 3054769285 | 51000 | 00 | ACEITO | 9AC4 | 9AC4 | SIM | 4 | NA | OK | NENHUM | ORDEM
3 | SUM | 762 | 762 | 763 | 3054821242 | 51957 | 00 | ACEITO | AAFF | AAFF | SIM | 3 | NA | OK | NENHUM | ORDEM
3 | SUM | 763 | 763 | 764 | 3054872242 | 51000 | 00 | ACEITO | 1283 | 1283 | SIM | 3 | NA | OK | NENHUM | ORDEM
3 | SUM | 764 | 764 | 765 | 3054923242 | 51000 | 00 | ACEITO | A9EF | A9EF | SIM | 3 | NA | OK | NENHUM | ORDEM
3 | SUM | 765 | 765 | 766 | 3054974242 | 51000 | 00 | ACEITO | F82B | F82B | SIM | 3 | NA | OK | NENHUM | ORDEM
3 | SUM | 766 | 766 | 767 | 3055025242 | 51000 | 00 | ACEITO | 31FB | 31FB | SIM | 3 | NA | OK | NENHUM | ORDEM
3 | SUM | 767 | 767 | 768 | 3055076242 | 51000 | 00 | ACEITO | 414E | 414E | SIM | 3 | NA | OK | NENHUM | ORDEM
3 | SUM | 768 | 768 | 769 | 3055127242 | 51000 | 00 | ACEITO | AE23 | AE23 | SIM | 3 | NA | OK | NENHUM | ORDEM
3 | SUM | 769 | 769 | 770 | 3055178242 | 51000 | 00 | ACEITO | 6326 | 6326 | SIM | 3 | NA | OK | NENHUM | ORDEM
3 | SUM | 770 | 770 | 771 | 3055229242 | 51000 | 00 | ACEITO | B09C | B09C | SIM | 3 | NA | OK | NENHUM | ORDEM
3 | SUM | 771 | 771 | 772 | 3055280242 | 51000 | 00 | ACEITO | 0A7F | 0A7F | SIM | 3 | NA | OK | NENHUM | ORDEM
3 | SUM | 772 | 772 | 773 | 3055331242 | 51000 | 00 | ACEITO | 5E4C | 5E4C | SIM | 3 | NA | OK | NENHUM | ORDEM
3 | SUM | 773 | 773 | 774 | 3055382242 | 51000 | 00 | ACEITO | CA39 | CA39 | SIM | 3 | NA | OK | NENHUM | ORDEM
3 | SUM | 774 | 774 | 775 | 3055433242 | 51000 | 00 | ACEITO | 1839 | 1839 | SIM | 3 | NA | OK | NENHUM | ORDEM
3 | SUM | 775 | 775 | 776 | 3055484242 | 51000 | 00 | ACEITO | 6F09 | 6F09 | SIM | 3 | NA | OK | NENHUM | ORDEM
3 | SUM | 776 | 776 | 777 | 3055535242 | 51000 | 00 | ACEITO | 31DB | 31DB | SIM | 3 | NA | OK | NENHUM | ORDEM
3 | SUM | 777 | 777 | 778 | 3055586242 | 51000 | 00 | ACEITO | EA5D | EA5D | SIM | 3 | NA | OK | NENHUM | ORDEM
3 | SUM | 778 | 778 | 779 | 3055637242 | 51000 | 00 | ACEITO | 17AE | 17AE | SIM | 3 | NA | OK | NENHUM | ORDEM
3 | SUM | 779 | 779 | 780 | 3055688242 | 51000 | 00 | ACEITO | DFB9 | DFB9 | SIM | 3 | NA | OK | NENHUM | ORDEM
3 | SUM | 780 | 780 | 781 | 3055739242 | 51000 | 00 | ACEITO | 205E | 205E | SIM | 3 | NA | OK | NENHUM | ORDEM
3 | SUM | 781 | 781 | 782 | 3055790242 | 51000 | 00 | ACEITO | 1C48 | 1C48 | SIM | 3 | NA | OK | NENHUM | ORDEM
3 | SUM | 782 | 782 | 783 | 3055841242 | 51000 | 00 | ACEITO | 8890 | 8890 | SIM | 3 | NA | OK | NENHUM | ORDEM
3 | SUM | 783 | 783 | 784 | 3055892242 | 51000 | 00 | ACEITO | FB90 | FB90 | SIM | 3 | NA | OK | NENHUM | ORDEM
3 | SUM | 784 | 784 | 785 | 3055943242 | 51000 | 00 | ACEITO | 5B7F | 5B7F | SIM | 3 | NA | OK | NENHUM | ORDEM
3 | SUM | 785 | 785 | 786 | 3055994242 | 51000 | 00 | ACEITO | 6CBC | 6CBC | SIM | 3 | NA | OK | NENHUM | ORDEM
3 | SUM | 786 | 786 | 787 | 3056045242 | 51000 | 00 | ACEITO | 4284 | 4284 | SIM | 3 | NA | OK | NENHUM | ORDEM
3 | SUM | 787 | 787 | 788 | 3056096242 | 51000 | 00 | ACEITO | 31A4 | 31A4 | SIM | 3 | NA | OK | NENHUM | ORDEM
3 | SUM | 788 | 788 | 789 | 3056147242 | 51000 | 00 | ACEITO | 9E81 | 9E81 | SIM | 3 | NA | OK | NENHUM | ORDEM
3 | SUM | 789 | 789 | 790 | 3056198242 | 51000 | 00 | ACEITO | E39F | E39F | SIM | 3 | NA | OK | NENHUM | ORDEM
3 | SUM | 790 | 790 | 791 | 3056249242 | 51000 | 00 | ACEITO | D758 | D758 | SIM | 3 | NA | OK | NENHUM | ORDEM
3 | SUM | 791 | 791 | 792 | 3056300242 | 51000 | 00 | ACEITO | BD5A | BD5A | SIM | 3 | NA | OK | NENHUM | ORDEM
3 | SUM | 792 | 792 | 793 | 3056351242 | 51000 | 00 | ACEITO | B292 | B292 | SIM | 3 | NA | OK | NENHUM | ORDEM
3 | SUM | 793 | 793 | 794 | 3056402242 | 51000 | 00 | ACEITO | 4955 | 4955 | SIM | 3 | NA | OK | NENHUM | ORDEM
3 | SUM | 794 | 794 | 795 | 3056453242 | 51000 | 00 | ACEITO | 458A | 458A | SIM | 3 | NA | OK | NENHUM | ORDEM
3 | SUM | 795 | 795 | 796 | 3056504242 | 51000 | 00 | ACEITO | C673 | C673 | SIM | 3 | NA | OK | NENHUM | ORDEM
3 | SUM | 796 | 796 | 797 | 3056555242 | 51000 | 00 | ACEITO | 43D6 | 43D6 | SIM | 3 | NA | OK | NENHUM | ORDEM
3 | SUM | 797 | 797 | 798 | 3056606242 | 51000 | 00 | ACEITO | 13CD | 13CD | SIM | 3 | NA | OK | NENHUM | ORDEM
3 | SUM | 798 | 798 | 799 | 3056657242 | 51000 | 00 | ACEITO | 83DB | 83DB | SIM | 3 | NA | OK | NENHUM | ORDEM
3 | SUM | 799 | 799 | 800 | 3056708242 | 51000 | 00 | ACEITO | F416 | F416 | SIM | 3 | NA | OK | NENHUM | ORDEM
3 | SUM | 800 | 800 | 801 | 3056759242 | 51000 | 00 | ACEITO | 4DC5 | 4DC5 | SIM | 3 | NA | OK | NENHUM | ORDEM
3 | SUM | 801 | 801 | 802 | 3056810242 | 51000 | 00 | ACEITO | 6208 | 6208 | SIM | 3 | NA | OK | NENHUM | ORDEM
3 | SUM | 802 | 802 | 803 | 3056861242 | 51000 | 00 | ACEITO | 4F85 | 4F85 | SIM | 3 | NA | OK | NENHUM | ORDEM
3 | SUM | 803 | 803 | 804 | 3056912242 | 51000 | 00 | ACEITO | 4BCA | 4BCA | SIM | 3 | NA | OK | NENHUM | ORDEM
3 | SUM | 804 | 804 | 805 | 3056963242 | 51000 | 00 | ACEITO | 54D0 | 54D0 | SIM | 3 | NA | OK | NENHUM | ORDEM
3 | SUM | 805 | 805 | 806 | 3057014242 | 51000 | 00 | ACEITO | E67A | E67A | SIM | 3 | NA | OK | NENHUM | ORDEM
3 | SUM | 806 | 806 | 807 | 3057065242 | 51000 | 00 | ACEITO | 7B8D | 7B8D | SIM | 3 | NA | OK | NENHUM | ORDEM
3 | SUM | 807 | 807 | 808 | 3057116242 | 51000 | 00 | ACEITO | 2711 | 2711 | SIM | 3 | NA | OK | NENHUM | ORDEM
3 | SUM | 808 | 808 | 809 | 3057167242 | 51000 | 00 | ACEITO | 2542 | 2542 | SIM | 3 | NA | OK | NENHUM | ORDEM
3 | SUM | 809 | 809 | 810 | 3057218242 | 51000 | 00 | ACEITO | 0CB8 | 0CB8 | SIM | 3 | NA | OK | NENHUM | ORDEM
3 | SUM | 810 | 810 | 811 | 3057269242 | 51000 | 00 | ACEITO | 6717 | 6717 | SIM | 3 | NA | OK | NENHUM | ORDEM
3 | SUM | 811 | 811 | 812 | 3057320242 | 51000 | 00 | ACEITO | 4B48 | 4B48 | SIM | 3 | NA | OK | NENHUM | ORDEM
3 | SUM | 812 | 812 | 813 | 3057371242 | 51000 | 00 | ACEITO | 4971 | 4971 | SIM | 3 | NA | OK | NENHUM | ORDEM
3 | SUM | 813 | 813 | 814 | 3057422242 | 51000 | 00 | ACEITO | 6894 | 6894 | SIM | 3 | NA | OK | NENHUM | ORDEM
3 | SUM | 814 | 814 | 815 | 3057473242 | 51000 | 00 | ACEITO | 24C4 | 24C4 | SIM | 3 | NA | OK | NENHUM | ORDEM
3 | SUM | 815 | 815 | 816 | 3057524242 | 51000 | 00 | ACEITO | 45D9 | 45D9 | SIM | 3 | NA | OK | NENHUM | ORDEM
3 | SUM | 816 | 816 | 817 | 3057575242 | 51000 | 00 | ACEITO | 6652 | 6652 | SIM | 3 | NA | OK | NENHUM | ORDEM
3 | SUM | 817 | 817 | 818 | 3057626242 | 51000 | 00 | ACEITO | E0D7 | E0D7 | SIM | 3 | NA | OK | NENHUM | ORDEM
3 | SUM | 818 | 818 | 819 | 3057677242 | 51000 | 00 | ACEITO | BC54 | BC54 | SIM | 3 | NA | OK | NENHUM | ORDEM
3 | SUM | 819 | 819 | 820 | 3057728242 | 51000 | 00 | ACEITO | DDDE | DDDE | SIM | 3 | NA | OK | NENHUM | ORDEM
3 | SUM | 820 | 820 | 821 | 3057779242 | 51000 | 00 | ACEITO | 5F95 | 5F95 | SIM | 3 | NA | OK | NENHUM | ORDEM
3 | SUM | 821 | 821 | 822 | 3057830242 | 51000 | 00 | ACEITO | AB5C | AB5C | SIM | 3 | NA | OK | NENHUM | ORDEM
3 | SUM | 822 | 822 | 823 | 3057881242 | 51000 | 00 | ACEITO | F086 | F086 | SIM | 3 | NA | OK | NENHUM | ORDEM
3 | SUM | 823 | 823 | 824 | 3057932242 | 51000 | 00 | ACEITO | 3271 | 3271 | SIM | 3 | NA | OK | NENHUM | ORDEM
3 | SUM | 824 | 824 | 825 | 3057983242 | 51000 | 00 | ACEITO | 0EDF | 0EDF | SIM | 3 | NA | OK | NENHUM | ORDEM
3 | SUM | 825 | 825 | 826 | 3058034242 | 51000 | 00 | ACEITO | D9EB | D9EB | SIM | 3 | NA | OK | NENHUM | ORDEM
3 | SUM | 826 | 826 | 827 | 3058085242 | 51000 | 00 | ACEITO | 61CF | 61CF | SIM | 3 | NA | OK | NENHUM | ORDEM
3 | SUM | 827 | 827 | 828 | 3058136242 | 51000 | 00 | ACEITO | BDAE | BDAE | SIM | 3 | NA | OK | NENHUM | ORDEM
3 | SUM | 828 | 828 | 829 | 3058187242 | 51000 | 00 | ACEITO | 497A | 497A | SIM | 3 | NA | OK | NENHUM | ORDEM
3 | SUM | 829 | 829 | 830 | 3058238242 | 51000 | 00 | ACEITO | 7A7F | 7A7F | SIM | 3 | NA | OK | NENHUM | ORDEM
3 | SUM | 830 | 830 | 831 | 3058289242 | 51000 | 00 | ACEITO | 7329 | 7329 | SIM | 3 | NA | OK | NENHUM | ORDEM
3 | SUM | 831 | 831 | 832 | 3058340242 | 51000 | 00 | ACEITO | C3E4 | C3E4 | SIM | 3 | NA | OK | NENHUM | ORDEM
3 | SUM | 832 | 832 | 833 | 3058391242 | 51000 | 00 | ACEITO | 2E79 | 2E79 | SIM | 3 | NA | OK | NENHUM | ORDEM
3 | SUM | 833 | 833 | 834 | 3058442242 | 51000 | 00 | ACEITO | 6440 | 6440 | SIM | 3 | NA | OK | NENHUM | ORDEM
3 | SUM | 834 | 834 | 835 | 3058493242 | 51000 | 00 | ACEITO | 4CEA | 4CEA | SIM | 3 | NA | OK | NENHUM | ORDEM
3 | SUM | 835 | 835 | 836 | 3058544242 | 51000 | 00 | ACEITO | 6A61 | 6A61 | SIM | 3 | NA | OK | NENHUM | ORDEM
3 | SUM | 836 | 836 | 837 | 3058595242 | 51000 | 00 | ACEITO | 8446 | 8446 | SIM | 3 | NA | OK | NENHUM | ORDEM
3 | SUM | 837 | 837 | 838 | 3058646242 | 51000 | 00 | ACEITO | 7FB1 | 7FB1 | SIM | 3 | NA | OK | NENHUM | ORDEM
3 | SUM | 838 | 838 | 839 | 3058697242 | 51000 | 00 | ACEITO | BAC8 | BAC8 | SIM | 3 | NA | OK | NENHUM | ORDEM
3 | SUM | 839 | 839 | 840 | 3058748242 | 51000 | 00 | ACEITO | 3022 | 3022 | SIM | 3 | NA | OK | NENHUM | ORDEM
3 | SUM | 840 | 840 | 841 | 3058799242 | 51000 | 00 | ACEITO | 1529 | 1529 | SIM | 3 | NA | OK | NENHUM | ORDEM
3 | SUM | 841 | 841 | 842 | 3058850251 | 51009 | 00 | ACEITO | 55D6 | 55D6 | SIM | 3 | NA | OK | NENHUM | ORDEM
3 | SUM | 842 | 842 | 843 | 3058901250 | 50999 | 00 | ACEITO | 35C9 | 35C9 | SIM | 3 | NA | OK | NENHUM | ORDEM
3 | SUM | 843 | 843 | 844 | 3058952251 | 51001 | 00 | ACEITO | E19F | E19F | SIM | 3 | NA | OK | NENHUM | ORDEM
3 | SUM | 844 | 844 | 845 | 3059003250 | 50999 | 00 | ACEITO | 0293 | 0293 | SIM | 3 | NA | OK | NENHUM | ORDEM
3 | SUM | 845 | 845 | 846 | 3059054251 | 51001 | 00 | ACEITO | 0706 | 0706 | SIM | 3 | NA | OK | NENHUM | ORDEM
3 | SUM | 846 | 846 | 847 | 3059105250 | 50999 | 00 | ACEITO | D573 | D573 | SIM | 3 | NA | OK | NENHUM | ORDEM
3 | SUM | 847 | 847 | 848 | 3059156251 | 51001 | 00 | ACEITO | 01F8 | 01F8 | SIM | 3 | NA | OK | NENHUM | ORDEM
3 | SUM | 848 | 848 | 849 | 3059207250 | 50999 | 00 | ACEITO | 46CE | 46CE | SIM | 3 | NA | OK | NENHUM | ORDEM
3 | SUM | 849 | 849 | 850 | 3059258251 | 51001 | 00 | ACEITO | 3940 | 3940 | SIM | 3 | NA | OK | NENHUM | ORDEM
3 | SUM | 850 | 850 | 851 | 3059309250 | 50999 | 00 | ACEITO | 5E60 | 5E60 | SIM | 3 | NA | OK | NENHUM | ORDEM
3 | SUM | 851 | 851 | 852 | 3059360251 | 51001 | 00 | ACEITO | 01D1 | 01D1 | SIM | 3 | NA | OK | NENHUM | ORDEM
3 | SUM | 852 | 852 | 853 | 3059411250 | 50999 | 00 | ACEITO | D70A | D70A | SIM | 3 | NA | OK | NENHUM | ORDEM
3 | SUM | 853 | 853 | 854 | 3059462251 | 51001 | 00 | ACEITO | 7420 | 7420 | SIM | 3 | NA | OK | NENHUM | ORDEM
3 | SUM | 854 | 854 | 855 | 3059513250 | 50999 | 00 | ACEITO | 2564 | 2564 | SIM | 3 | NA | OK | NENHUM | ORDEM
3 | SUM | 855 | 855 | 856 | 3059564251 | 51001 | 00 | ACEITO | 3534 | 3534 | SIM | 3 | NA | OK | NENHUM | ORDEM
3 | SUM | 856 | 856 | 857 | 3059615250 | 50999 | 00 | ACEITO | 1749 | 1749 | SIM | 3 | NA | OK | NENHUM | ORDEM
3 | SUM | 857 | 857 | 858 | 3059666251 | 51001 | 00 | ACEITO | 775E | 775E | SIM | 3 | NA | OK | NENHUM | ORDEM
3 | SUM | 858 | 858 | 859 | 3059717250 | 50999 | 00 | ACEITO | 55A9 | 55A9 | SIM | 3 | NA | OK | NENHUM | ORDEM
3 | SUM | 859 | 859 | 860 | 3059768251 | 51001 | 00 | ACEITO | AA67 | AA67 | SIM | 3 | NA | OK | NENHUM | ORDEM
3 | SUM | 860 | 860 | 861 | 3059819250 | 50999 | 00 | ACEITO | 0274 | 0274 | SIM | 3 | NA | OK | NENHUM | ORDEM
3 | SUM | 861 | 861 | 862 | 3059870251 | 51001 | 00 | ACEITO | BCBF | BCBF | SIM | 3 | NA | OK | NENHUM | ORDEM
3 | SUM | 862 | 862 | 863 | 3059921250 | 50999 | 00 | ACEITO | E31F | E31F | SIM | 3 | NA | OK | NENHUM | ORDEM
3 | SUM | 863 | 863 | 864 | 3059972251 | 51001 | 00 | ACEITO | 8C3C | 8C3C | SIM | 3 | NA | OK | NENHUM | ORDEM
3 | SUM | 864 | 864 | 865 | 3060023250 | 50999 | 00 | ACEITO | D037 | D037 | SIM | 3 | NA | OK | NENHUM | ORDEM
3 | SUM | 865 | 865 | 866 | 3060074251 | 51001 | 00 | ACEITO | FF62 | FF62 | SIM | 3 | NA | OK | NENHUM | ORDEM
3 | SUM | 866 | 866 | 867 | 3060125250 | 50999 | 00 | ACEITO | 7579 | 7579 | SIM | 3 | NA | OK | NENHUM | ORDEM
3 | SUM | 867 | 867 | 868 | 3060176246 | 50996 | 00 | ACEITO | FE37 | FE37 | SIM | 4 | NA | OK | NENHUM | ORDEM
3 | SUM | 868 | 868 | 869 | 3060227245 | 50999 | 00 | ACEITO | ED5F | ED5F | SIM | 3 | NA | OK | NENHUM | ORDEM
3 | SUM | 869 | 869 | 870 | 3060278246 | 51001 | 00 | ACEITO | B868 | B868 | SIM | 4 | NA | OK | NENHUM | ORDEM
3 | SUM | 870 | 870 | 871 | 3060329245 | 50999 | 00 | ACEITO | B064 | B064 | SIM | 3 | NA | OK | NENHUM | ORDEM
3 | SUM | 871 | 871 | 872 | 3060380246 | 51001 | 00 | ACEITO | BD03 | BD03 | SIM | 4 | NA | OK | NENHUM | ORDEM
3 | SUM | 872 | 872 | 873 | 3060431245 | 50999 | 00 | ACEITO | DF11 | DF11 | SIM | 3 | NA | OK | NENHUM | ORDEM
3 | SUM | 873 | 873 | 874 | 3060482246 | 51001 | 00 | ACEITO | 8A29 | 8A29 | SIM | 4 | NA | OK | NENHUM | ORDEM
3 | SUM | 874 | 874 | 875 | 3060533245 | 50999 | 00 | ACEITO | 694E | 694E | SIM | 3 | NA | OK | NENHUM | ORDEM
3 | SUM | 875 | 875 | 876 | 3060584246 | 51001 | 00 | ACEITO | 2CFD | 2CFD | SIM | 4 | NA | OK | NENHUM | ORDEM
3 | SUM | 876 | 876 | 877 | 3060635245 | 50999 | 00 | ACEITO | 2BD4 | 2BD4 | SIM | 3 | NA | OK | NENHUM | ORDEM
3 | SUM | 877 | 877 | 878 | 3060686246 | 51001 | 00 | ACEITO | BEAF | BEAF | SIM | 4 | NA | OK | NENHUM | ORDEM
3 | SUM | 878 | 878 | 879 | 3060737245 | 50999 | 00 | ACEITO | A1A1 | A1A1 | SIM | 3 | NA | OK | NENHUM | ORDEM
3 | SUM | 879 | 879 | 880 | 3060788246 | 51001 | 00 | ACEITO | 7475 | 7475 | SIM | 4 | NA | OK | NENHUM | ORDEM
3 | SUM | 880 | 880 | 881 | 3060839242 | 50996 | 00 | ACEITO | 5ACC | 5ACC | SIM | 3 | NA | OK | NENHUM | ORDEM
3 | SUM | 881 | 881 | 882 | 3060890243 | 51001 | 00 | ACEITO | 6BCB | 6BCB | SIM | 3 | NA | OK | NENHUM | ORDEM
3 | SUM | 882 | 882 | 883 | 3060941242 | 50999 | 00 | ACEITO | 6A7C | 6A7C | SIM | 3 | NA | OK | NENHUM | ORDEM
3 | SUM | 883 | 883 | 884 | 3060992243 | 51001 | 00 | ACEITO | 79A1 | 79A1 | SIM | 3 | NA | OK | NENHUM | ORDEM
3 | SUM | 884 | 884 | 885 | 3061043242 | 50999 | 00 | ACEITO | 5565 | 5565 | SIM | 3 | NA | OK | NENHUM | ORDEM
3 | SUM | 885 | 885 | 886 | 3061094243 | 51001 | 00 | ACEITO | 1F21 | 1F21 | SIM | 3 | NA | OK | NENHUM | ORDEM
3 | SUM | 886 | 886 | 887 | 3061145242 | 50999 | 00 | ACEITO | 5393 | 5393 | SIM | 3 | NA | OK | NENHUM | ORDEM
3 | SUM | 887 | 887 | 888 | 3061196243 | 51001 | 00 | ACEITO | 6AEF | 6AEF | SIM | 3 | NA | OK | NENHUM | ORDEM
3 | SUM | 888 | 888 | 889 | 3061247242 | 50999 | 00 | ACEITO | 5CB2 | 5CB2 | SIM | 3 | NA | OK | NENHUM | ORDEM
3 | SUM | 889 | 889 | 890 | 3061298243 | 51001 | 00 | ACEITO | 9D60 | 9D60 | SIM | 3 | NA | OK | NENHUM | ORDEM
3 | SUM | 890 | 890 | 891 | 3061349242 | 50999 | 00 | ACEITO | 42C3 | 42C3 | SIM | 3 | NA | OK | NENHUM | ORDEM
3 | SUM | 891 | 891 | 892 | 3061400243 | 51001 | 00 | ACEITO | 415E | 415E | SIM | 3 | NA | OK | NENHUM | ORDEM
3 | SUM | 892 | 892 | 893 | 3061451242 | 50999 | 00 | ACEITO | D0AA | D0AA | SIM | 3 | NA | OK | NENHUM | ORDEM
3 | SUM | 893 | 893 | 894 | 3061502243 | 51001 | 00 | ACEITO | 7B6A | 7B6A | SIM | 3 | NA | OK | NENHUM | ORDEM
3 | SUM | 894 | 894 | 895 | 3061553242 | 50999 | 00 | ACEITO | 7097 | 7097 | SIM | 3 | NA | OK | NENHUM | ORDEM
3 | SUM | 895 | 895 | 896 | 3061604243 | 51001 | 00 | ACEITO | 83F4 | 83F4 | SIM | 3 | NA | OK | NENHUM | ORDEM
3 | SUM | 896 | 896 | 897 | 3061655242 | 50999 | 00 | ACEITO | 0DFC | 0DFC | SIM | 3 | NA | OK | NENHUM | ORDEM
3 | SUM | 897 | 897 | 898 | 3061706243 | 51001 | 00 | ACEITO | 0F9C | 0F9C | SIM | 3 | NA | OK | NENHUM | ORDEM
3 | SUM | 898 | 898 | 899 | 3061757242 | 50999 | 00 | ACEITO | BD0B | BD0B | SIM | 3 | NA | OK | NENHUM | ORDEM
3 | SUM | 899 | 899 | 900 | 3061808243 | 51001 | 00 | ACEITO | 71F7 | 71F7 | SIM | 3 | NA | OK | NENHUM | ORDEM
3 | SUM | 900 | 900 | 901 | 3061859242 | 50999 | 00 | ACEITO | CEEC | CEEC | SIM | 3 | NA | OK | NENHUM | ORDEM
3 | SUM | 901 | 901 | 902 | 3061910243 | 51001 | 00 | ACEITO | A39D | A39D | SIM | 3 | NA | OK | NENHUM | ORDEM
3 | SUM | 902 | 902 | 903 | 3061961242 | 50999 | 00 | ACEITO | 0D21 | 0D21 | SIM | 3 | NA | OK | NENHUM | ORDEM
3 | SUM | 903 | 903 | 904 | 3062012243 | 51001 | 00 | ACEITO | 0737 | 0737 | SIM | 3 | NA | OK | NENHUM | ORDEM
3 | SUM | 904 | 904 | 905 | 3062063242 | 50999 | 00 | ACEITO | 193A | 193A | SIM | 3 | NA | OK | NENHUM | ORDEM
3 | SUM | 905 | 905 | 906 | 3062114243 | 51001 | 00 | ACEITO | 7AB7 | 7AB7 | SIM | 3 | NA | OK | NENHUM | ORDEM
3 | SUM | 906 | 906 | 907 | 3062165242 | 50999 | 00 | ACEITO | 920C | 920C | SIM | 3 | NA | OK | NENHUM | ORDEM
3 | SUM | 907 | 907 | 908 | 3062216243 | 51001 | 00 | ACEITO | 98AF | 98AF | SIM | 3 | NA | OK | NENHUM | ORDEM
3 | SUM | 908 | 908 | 909 | 3062267242 | 50999 | 00 | ACEITO | D77D | D77D | SIM | 3 | NA | OK | NENHUM | ORDEM
3 | SUM | 909 | 909 | 910 | 3062318243 | 51001 | 00 | ACEITO | 4961 | 4961 | SIM | 3 | NA | OK | NENHUM | ORDEM
3 | SUM | 910 | 910 | 911 | 3062369242 | 50999 | 00 | ACEITO | 7883 | 7883 | SIM | 3 | NA | OK | NENHUM | ORDEM
3 | SUM | 911 | 911 | 912 | 3062420243 | 51001 | 00 | ACEITO | 3C6B | 3C6B | SIM | 3 | NA | OK | NENHUM | ORDEM
3 | SUM | 912 | 912 | 913 | 3062471242 | 50999 | 00 | ACEITO | C94D | C94D | SIM | 3 | NA | OK | NENHUM | ORDEM
3 | SUM | 913 | 913 | 914 | 3062522243 | 51001 | 00 | ACEITO | 6143 | 6143 | SIM | 3 | NA | OK | NENHUM | ORDEM
3 | SUM | 914 | 914 | 915 | 3062573242 | 50999 | 00 | ACEITO | 6360 | 6360 | SIM | 3 | NA | OK | NENHUM | ORDEM
3 | SUM | 915 | 915 | 916 | 3062624243 | 51001 | 00 | ACEITO | F8A1 | F8A1 | SIM | 3 | NA | OK | NENHUM | ORDEM
3 | SUM | 916 | 916 | 917 | 3062675242 | 50999 | 00 | ACEITO | 6A36 | 6A36 | SIM | 3 | NA | OK | NENHUM | ORDEM
3 | SUM | 917 | 917 | 918 | 3062726243 | 51001 | 00 | ACEITO | 6A64 | 6A64 | SIM | 3 | NA | OK | NENHUM | ORDEM
3 | SUM | 918 | 918 | 919 | 3062777242 | 50999 | 00 | ACEITO | 03A5 | 03A5 | SIM | 3 | NA | OK | NENHUM | ORDEM
3 | SUM | 919 | 919 | 920 | 3062828243 | 51001 | 00 | ACEITO | 0C96 | 0C96 | SIM | 3 | NA | OK | NENHUM | ORDEM
3 | SUM | 920 | 920 | 921 | 3062879242 | 50999 | 00 | ACEITO | C7A7 | C7A7 | SIM | 3 | NA | OK | NENHUM | ORDEM
3 | SUM | 921 | 921 | 922 | 3062930243 | 51001 | 00 | ACEITO | 51AE | 51AE | SIM | 3 | NA | OK | NENHUM | ORDEM
3 | SUM | 922 | 922 | 923 | 3062981242 | 50999 | 00 | ACEITO | 1F1E | 1F1E | SIM | 3 | NA | OK | NENHUM | ORDEM
3 | SUM | 923 | 923 | 924 | 3063032243 | 51001 | 00 | ACEITO | 7B2C | 7B2C | SIM | 3 | NA | OK | NENHUM | ORDEM
3 | SUM | 924 | 924 | 925 | 3063083242 | 50999 | 00 | ACEITO | 6118 | 6118 | SIM | 3 | NA | OK | NENHUM | ORDEM
3 | SUM | 925 | 925 | 926 | 3063134243 | 51001 | 00 | ACEITO | C7E8 | C7E8 | SIM | 3 | NA | OK | NENHUM | ORDEM
3 | SUM | 926 | 926 | 927 | 3063185242 | 50999 | 00 | ACEITO | 28F4 | 28F4 | SIM | 3 | NA | OK | NENHUM | ORDEM
3 | SUM | 927 | 927 | 928 | 3063236243 | 51001 | 00 | ACEITO | 5148 | 5148 | SIM | 3 | NA | OK | NENHUM | ORDEM
3 | SUM | 928 | 928 | 929 | 3063287242 | 50999 | 00 | ACEITO | C452 | C452 | SIM | 3 | NA | OK | NENHUM | ORDEM
3 | SUM | 929 | 929 | 930 | 3063338243 | 51001 | 00 | ACEITO | F7B7 | F7B7 | SIM | 3 | NA | OK | NENHUM | ORDEM
3 | SUM | 930 | 930 | 931 | 3063389242 | 50999 | 00 | ACEITO | 6350 | 6350 | SIM | 3 | NA | OK | NENHUM | ORDEM
3 | SUM | 931 | 931 | 932 | 3063440243 | 51001 | 00 | ACEITO | 16D8 | 16D8 | SIM | 3 | NA | OK | NENHUM | ORDEM
3 | SUM | 932 | 932 | 933 | 3063491242 | 50999 | 00 | ACEITO | 7D1E | 7D1E | SIM | 3 | NA | OK | NENHUM | ORDEM
3 | SUM | 933 | 933 | 934 | 3063542243 | 51001 | 00 | ACEITO | 5702 | 5702 | SIM | 3 | NA | OK | NENHUM | ORDEM
3 | SUM | 934 | 934 | 935 | 3063593242 | 50999 | 00 | ACEITO | 18C8 | 18C8 | SIM | 3 | NA | OK | NENHUM | ORDEM
3 | SUM | 935 | 935 | 936 | 3063644243 | 51001 | 00 | ACEITO | 7DF9 | 7DF9 | SIM | 3 | NA | OK | NENHUM | ORDEM
3 | SUM | 936 | 936 | 937 | 3063695242 | 50999 | 00 | ACEITO | 9CA5 | 9CA5 | SIM | 3 | NA | OK | NENHUM | ORDEM
3 | SUM | 937 | 937 | 938 | 3063746243 | 51001 | 00 | ACEITO | 04BB | 04BB | SIM | 3 | NA | OK | NENHUM | ORDEM
3 | SUM | 938 | 938 | 939 | 3063797242 | 50999 | 00 | ACEITO | 9189 | 9189 | SIM | 3 | NA | OK | NENHUM | ORDEM
3 | SUM | 939 | 939 | 940 | 3063848243 | 51001 | 00 | ACEITO | C674 | C674 | SIM | 3 | NA | OK | NENHUM | ORDEM
3 | SUM | 940 | 940 | 941 | 3063899242 | 50999 | 00 | ACEITO | 37FA | 37FA | SIM | 3 | NA | OK | NENHUM | ORDEM
3 | SUM | 941 | 941 | 942 | 3063950243 | 51001 | 00 | ACEITO | 8158 | 8158 | SIM | 3 | NA | OK | NENHUM | ORDEM
3 | SUM | 942 | 942 | 943 | 3064001242 | 50999 | 00 | ACEITO | AFF6 | AFF6 | SIM | 3 | NA | OK | NENHUM | ORDEM
3 | SUM | 943 | 943 | 944 | 3064052243 | 51001 | 00 | ACEITO | 45C7 | 45C7 | SIM | 3 | NA | OK | NENHUM | ORDEM
3 | SUM | 944 | 944 | 945 | 3064103242 | 50999 | 00 | ACEITO | 4AD9 | 4AD9 | SIM | 3 | NA | OK | NENHUM | ORDEM
3 | SUM | 945 | 945 | 946 | 3064154243 | 51001 | 00 | ACEITO | A08D | A08D | SIM | 3 | NA | OK | NENHUM | ORDEM
3 | SUM | 946 | 946 | 947 | 3064205242 | 50999 | 00 | ACEITO | B5FB | B5FB | SIM | 3 | NA | OK | NENHUM | ORDEM
3 | SUM | 947 | 947 | 948 | 3064256243 | 51001 | 00 | ACEITO | 8F78 | 8F78 | SIM | 3 | NA | OK | NENHUM | ORDEM
3 | SUM | 948 | 948 | 949 | 3064307242 | 50999 | 00 | ACEITO | 6D65 | 6D65 | SIM | 3 | NA | OK | NENHUM | ORDEM
3 | SUM | 949 | 949 | 950 | 3064358243 | 51001 | 00 | ACEITO | 3EDC | 3EDC | SIM | 3 | NA | OK | NENHUM | ORDEM
3 | SUM | 950 | 950 | 951 | 3064409242 | 50999 | 00 | ACEITO | ABF3 | ABF3 | SIM | 3 | NA | OK | NENHUM | ORDEM
3 | SUM | 951 | 951 | 952 | 3064460243 | 51001 | 00 | ACEITO | B8FF | B8FF | SIM | 3 | NA | OK | NENHUM | ORDEM
3 | SUM | 952 | 952 | 953 | 3064511242 | 50999 | 00 | ACEITO | 9831 | 9831 | SIM | 3 | NA | OK | NENHUM | ORDEM
3 | SUM | 953 | 953 | 954 | 3064562243 | 51001 | 00 | ACEITO | CC43 | CC43 | SIM | 3 | NA | OK | NENHUM | ORDEM
3 | SUM | 954 | 954 | 955 | 3064613242 | 50999 | 00 | ACEITO | CF6D | CF6D | SIM | 3 | NA | OK | NENHUM | ORDEM
3 | SUM | 955 | 955 | 956 | 3064664243 | 51001 | 00 | ACEITO | 72FD | 72FD | SIM | 3 | NA | OK | NENHUM | ORDEM
3 | SUM | 956 | 956 | 957 | 3064715242 | 50999 | 00 | ACEITO | 838A | 838A | SIM | 3 | NA | OK | NENHUM | ORDEM
3 | SUM | 957 | 957 | 958 | 3064766243 | 51001 | 00 | ACEITO | 8DE8 | 8DE8 | SIM | 3 | NA | OK | NENHUM | ORDEM
3 | SUM | 958 | 958 | 959 | 3064817242 | 50999 | 00 | ACEITO | 0BA1 | 0BA1 | SIM | 3 | NA | OK | NENHUM | ORDEM
3 | SUM | 959 | 959 | 960 | 3064868243 | 51001 | 00 | ACEITO | 09F3 | 09F3 | SIM | 3 | NA | OK | NENHUM | ORDEM
3 | SUM | 960 | 960 | 961 | 3064919242 | 50999 | 00 | ACEITO | FBA7 | FBA7 | SIM | 3 | NA | OK | NENHUM | ORDEM
3 | SUM | 961 | 961 | 962 | 3064970243 | 51001 | 00 | ACEITO | D610 | D610 | SIM | 3 | NA | OK | NENHUM | ORDEM
3 | SUM | 962 | 962 | 963 | 3065021242 | 50999 | 00 | ACEITO | 1C18 | 1C18 | SIM | 3 | NA | OK | NENHUM | ORDEM
3 | SUM | 963 | 963 | 964 | 3065072243 | 51001 | 00 | ACEITO | E86B | E86B | SIM | 3 | NA | OK | NENHUM | ORDEM
3 | SUM | 964 | 964 | 965 | 3065123242 | 50999 | 00 | ACEITO | 2EEE | 2EEE | SIM | 3 | NA | OK | NENHUM | ORDEM
3 | SUM | 965 | 965 | 966 | 3065174243 | 51001 | 00 | ACEITO | 548E | 548E | SIM | 3 | NA | OK | NENHUM | ORDEM
3 | SUM | 966 | 966 | 967 | 3065225242 | 50999 | 00 | ACEITO | 6851 | 6851 | SIM | 3 | NA | OK | NENHUM | ORDEM
3 | SUM | 967 | 967 | 968 | 3065276243 | 51001 | 00 | ACEITO | 493F | 493F | SIM | 3 | NA | OK | NENHUM | ORDEM
3 | SUM | 968 | 968 | 969 | 3065327242 | 50999 | 00 | ACEITO | FF63 | FF63 | SIM | 3 | NA | OK | NENHUM | ORDEM
3 | SUM | 969 | 969 | 970 | 3065378243 | 51001 | 00 | ACEITO | 6C1A | 6C1A | SIM | 3 | NA | OK | NENHUM | ORDEM
3 | SUM | 970 | 970 | 971 | 3065429242 | 50999 | 00 | ACEITO | 7E97 | 7E97 | SIM | 3 | NA | OK | NENHUM | ORDEM
3 | SUM | 971 | 971 | 972 | 3065480243 | 51001 | 00 | ACEITO | FF25 | FF25 | SIM | 3 | NA | OK | NENHUM | ORDEM
3 | SUM | 972 | 972 | 973 | 3065531242 | 50999 | 00 | ACEITO | A340 | A340 | SIM | 3 | NA | OK | NENHUM | ORDEM
3 | SUM | 973 | 973 | 974 | 3065582243 | 51001 | 00 | ACEITO | 6759 | 6759 | SIM | 3 | NA | OK | NENHUM | ORDEM
3 | SUM | 974 | 974 | 975 | 3065633242 | 50999 | 00 | ACEITO | A439 | A439 | SIM | 3 | NA | OK | NENHUM | ORDEM
3 | SUM | 975 | 975 | 976 | 3065684243 | 51001 | 00 | ACEITO | 9249 | 9249 | SIM | 3 | NA | OK | NENHUM | ORDEM
3 | SUM | 976 | 976 | 977 | 3065735242 | 50999 | 00 | ACEITO | 7738 | 7738 | SIM | 3 | NA | OK | NENHUM | ORDEM
3 | SUM | 977 | 977 | 978 | 3065786243 | 51001 | 00 | ACEITO | C309 | C309 | SIM | 3 | NA | OK | NENHUM | ORDEM
3 | SUM | 978 | 978 | 979 | 3065837242 | 50999 | 00 | ACEITO | C1E5 | C1E5 | SIM | 3 | NA | OK | NENHUM | ORDEM
3 | SUM | 979 | 979 | 980 | 3065888243 | 51001 | 00 | ACEITO | AED4 | AED4 | SIM | 3 | NA | OK | NENHUM | ORDEM
3 | SUM | 980 | 980 | 981 | 3065939242 | 50999 | 00 | ACEITO | 3D0A | 3D0A | SIM | 3 | NA | OK | NENHUM | ORDEM
3 | SUM | 981 | 981 | 982 | 3065990243 | 51001 | 00 | ACEITO | 4D85 | 4D85 | SIM | 3 | NA | OK | NENHUM | ORDEM
3 | SUM | 982 | 982 | 983 | 3066041242 | 50999 | 00 | ACEITO | 001E | 001E | SIM | 3 | NA | OK | NENHUM | ORDEM
3 | SUM | 983 | 983 | 984 | 3066092243 | 51001 | 00 | ACEITO | 43E4 | 43E4 | SIM | 3 | NA | OK | NENHUM | ORDEM
3 | SUM | 984 | 984 | 985 | 3066143242 | 50999 | 00 | ACEITO | 4D5F | 4D5F | SIM | 3 | NA | OK | NENHUM | ORDEM
3 | SUM | 985 | 985 | 986 | 3066194243 | 51001 | 00 | ACEITO | 8E66 | 8E66 | SIM | 3 | NA | OK | NENHUM | ORDEM
3 | SUM | 986 | 986 | 987 | 3066245242 | 50999 | 00 | ACEITO | 4294 | 4294 | SIM | 3 | NA | OK | NENHUM | ORDEM
3 | SUM | 987 | 987 | 988 | 3066296243 | 51001 | 00 | ACEITO | 1DDF | 1DDF | SIM | 3 | NA | OK | NENHUM | ORDEM
3 | SUM | 988 | 988 | 989 | 3066347242 | 50999 | 00 | ACEITO | AFB6 | AFB6 | SIM | 3 | NA | OK | NENHUM | ORDEM
3 | SUM | 989 | 989 | 990 | 3066398243 | 51001 | 00 | ACEITO | 1213 | 1213 | SIM | 3 | NA | OK | NENHUM | ORDEM
3 | SUM | 990 | 990 | 991 | 3066449242 | 50999 | 00 | ACEITO | E120 | E120 | SIM | 3 | NA | OK | NENHUM | ORDEM
3 | SUM | 991 | 991 | 992 | 3066500243 | 51001 | 00 | ACEITO | 8774 | 8774 | SIM | 3 | NA | OK | NENHUM | ORDEM
3 | SUM | 992 | 992 | 993 | 3066551242 | 50999 | 00 | ACEITO | 152B | 152B | SIM | 3 | NA | OK | NENHUM | ORDEM
3 | SUM | 993 | 993 | 994 | 3066602243 | 51001 | 00 | ACEITO | 1B69 | 1B69 | SIM | 3 | NA | OK | NENHUM | ORDEM
3 | SUM | 994 | 994 | 995 | 3066653242 | 50999 | 00 | ACEITO | 35CE | 35CE | SIM | 3 | NA | OK | NENHUM | ORDEM
3 | SUM | 995 | 995 | 996 | 3066704243 | 51001 | 00 | ACEITO | 5BF7 | 5BF7 | SIM | 3 | NA | OK | NENHUM | ORDEM
3 | SUM | 996 | 996 | 997 | 3066755242 | 50999 | 00 | ACEITO | 9557 | 9557 | SIM | 3 | NA | OK | NENHUM | ORDEM
3 | SUM | 997 | 997 | 998 | 3066806243 | 51001 | 00 | ACEITO | 5E1B | 5E1B | SIM | 3 | NA | OK | NENHUM | ORDEM
3 | SUM | 998 | 998 | 999 | 3066857242 | 50999 | 00 | ACEITO | F641 | F641 | SIM | 3 | NA | OK | NENHUM | ORDEM
3 | SUM | 999 | 999 | 1000 | 3066908243 | 51001 | 00 | ACEITO | 2701 | 2701 | SIM | 3 | NA | OK | NENHUM | ORDEM
