kauanSR-DEv/telemetria-esp32/resultados/coletas/20261019_174927_927081_SUM_M0_seed1/tabela_professor.csv

Modo | OK | CORROMPIDO | PERDIDO | Não detectado | Taxa de não detecção (%)
0 | 1000 | 0 | 0 | 0 | NA
