kauanSR-DEv/telemetria-esp32/resultados/coletas/20261019_174927_927081_SUM_M0_seed1/tx.csv

sessao | tecnica | seq | t_inicio_us | intervalo_us | payload_hex | quadro_hex | calculo_us
3 | SUM | 0 | 3051154224 | NA | 5E29 | A55A0200005E2977 | 2
3 | SUM | 1 | 3051205223 | 50999 | 0DB9 | A55A0200010DB937 | 1
3 | SUM | 2 | 3051256223 | 51000 | F55B | A55A020002F55BAC | 1
3 | SUM | 3 | 3051307223 | 51000 | 968F | A55A020003968FD6 | 1
3 | SUM | 4 | 3051358223 | 51000 | A5F3 | A55A020004A5F362 | 1
3 | SUM | 5 | 3051409223 | 51000 | 1EAC | A55A0200051EAC2F | 1
3 | SUM | 6 | 3051460223 | 51000 | 41AA | A55A02000641AA0D | 1
3 | SUM | 7 | 3051511223 | 51000 | 59E0 | A55A02000759E0BE | 1
3 | SUM | 8 | 3051562223 | 51000 | E071 | A55A020008E071A5 | 1
3 | SUM | 9 | 3051613223 | 51000 | D691 | A55A020009D6918E | 1
3 | SUM | 10 | 3051664223 | 51000 | 0154 | A55A02000A01549F | 1
3 | SUM | 11 | 3051715223 | 51000 | 05DA | A55A02000B05DA14 | 1
3 | SUM | 12 | 3051766223 | 51000 | 49A3 | A55A02000C49A306 | 1
3 | SUM | 13 | 3051817223 | 51000 | AEA4 | A55A02000DAEA49F | 1
3 | SUM | 14 | 3051868223 | 51000 | B36F | A55A02000EB36FCE | 1
3 | SUM | 15 | 3051919223 | 51000 | 53DB | A55A02000F53DBC1 | 1
3 | SUM | 16 | 3051970223 | 51000 | E1AF | A55A020010E1AF5E | 1
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
