kauanSR-DEv/telemetria-esp32/(commit log)

2026-10-20 Adicão dos resultados das 7 rodadas de teste!
    [CRC8.csv, SUM.csv, comandos.csv, evidencias_nd.csv, noise.csv, rx.csv, tabela_professor.csv, tx.csv]
2026-10-28 Corrige a tabela de resultados do README
2026-10-28 Corrige o link do relatório para o PDF e o Word atuais
